vimark/Leadtech-arduino-CSPG/hardware/docs/contact_circuit_protection.pdf

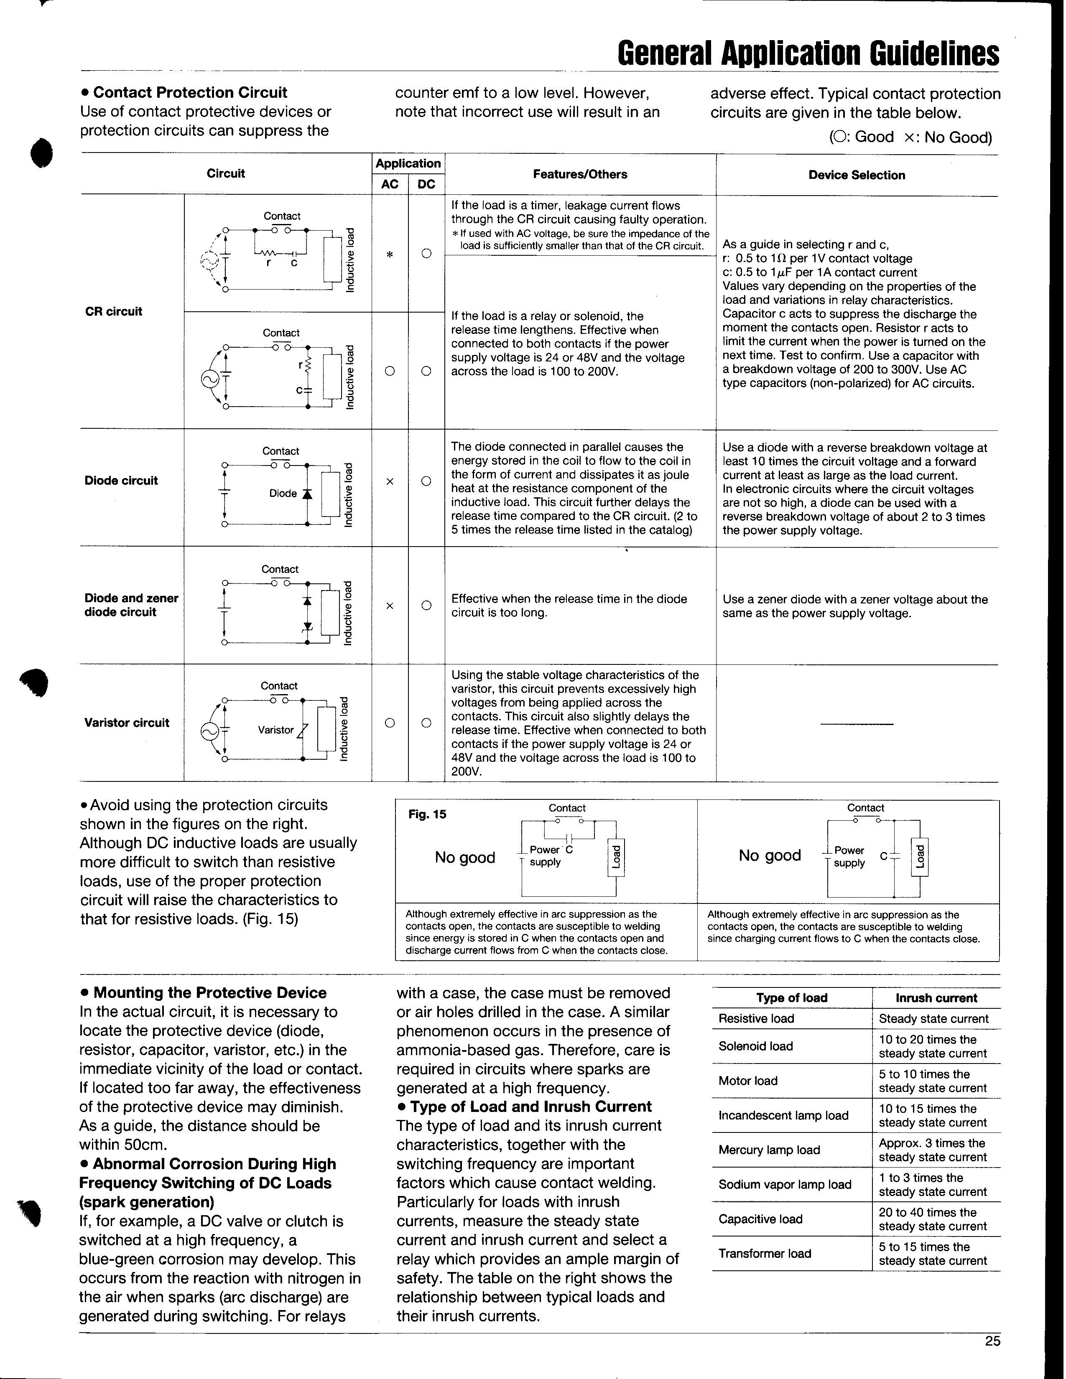
[picture p1: page 1]
