vimark/Leadtech-arduino-CSPG/hardware/docs/Astron RS-35A, RS-35M schematic.pdf

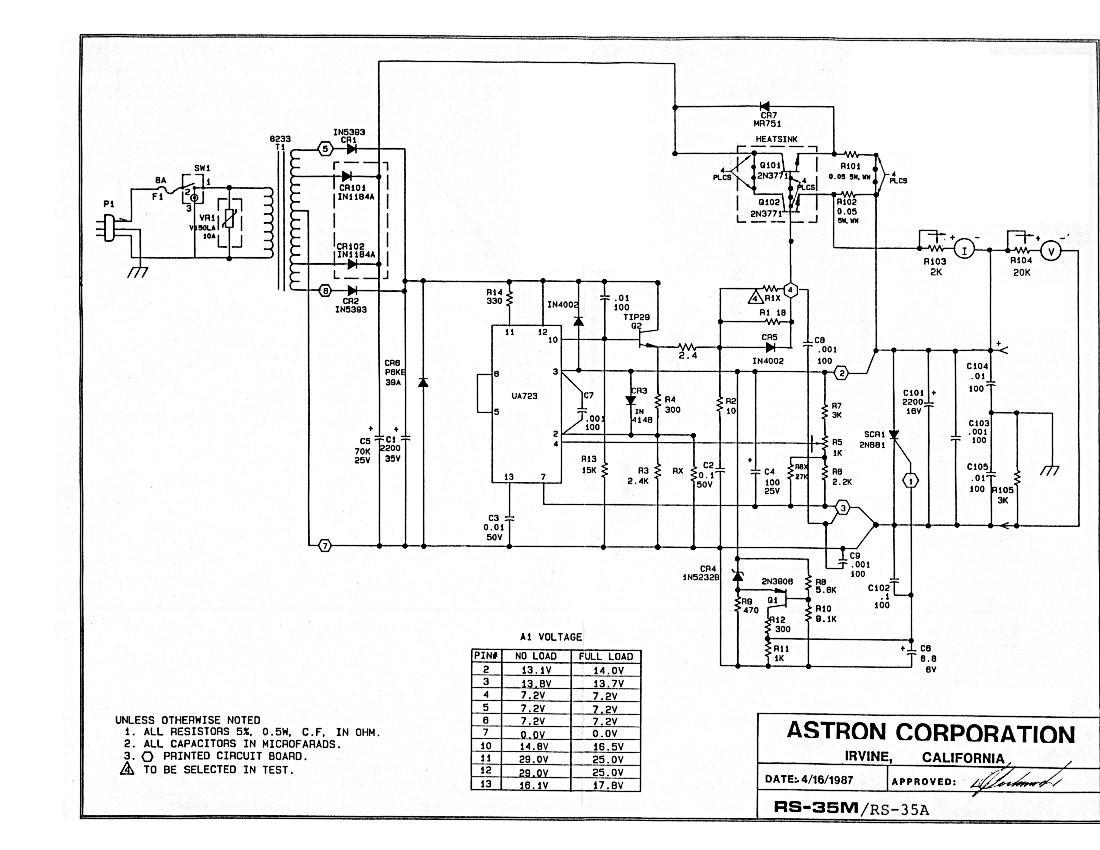
[picture p2: page 1]
