vimark/Leadtech-arduino-CSPG/hardware/docs/1.3 inch oled 128x64 i2c 3-1000x1000.jpg

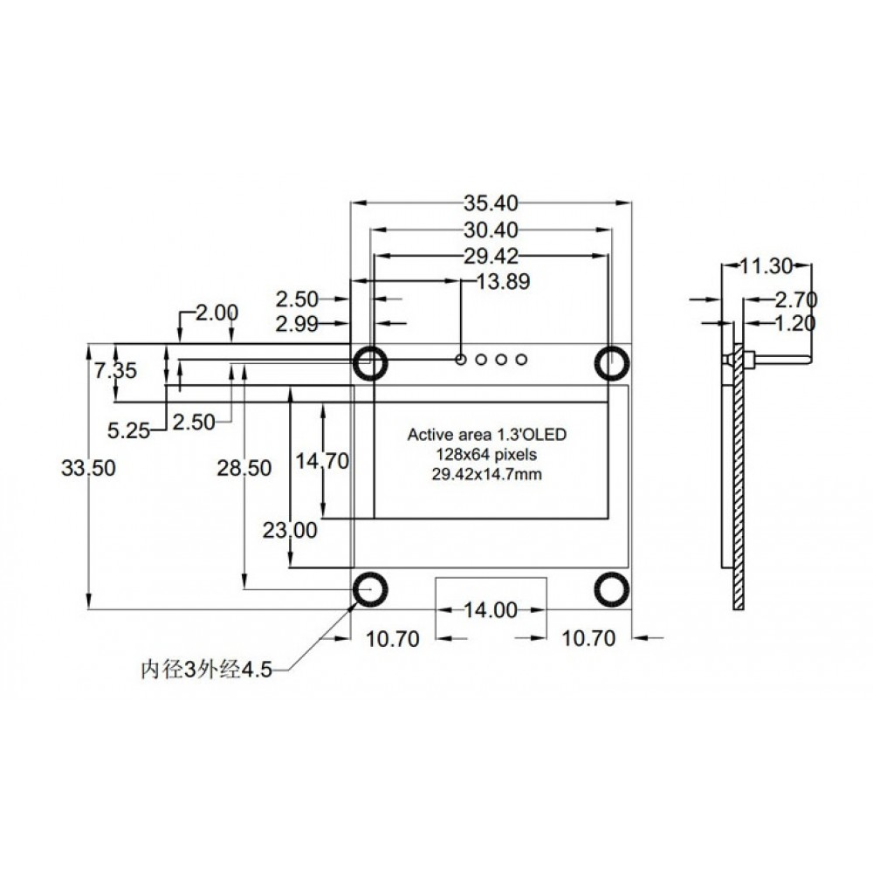
hardware/docs/1.3 inch oled 128x64 i2c 3-1000x1000.jpg
