vimark/Leadtech-arduino-CSPG/hardware/leadtech-arduino-CSPG_concept-bom.xlsx

Qty | Value | Device | Package | Parts | Description | LCSC part no | Mfr no | Brand | Price | Desciption |  | Multiple of 10 | 10
1 |  | LED-0805 | LED-805 | LED1 | Light Emitting Diode | C131244 | 17-21SURC/S530-A2/TR8 | Everlight Elec | $0.014274 |  | $0.01
1 |  | TRANSISTOR_FET_TSM2301CX | SOT-23 | Q1 | 20V P-Channel Enhancement Mode MOSFET | C375701 | GP2301 | GP(GreenPower) | $0.031213 |  | $0.03
10 | 0.1uF | C-EUC0603 | C0603 | C4, C5, C6, C8, C9, C10, C11, C12, C13, C18 | CAPACITOR, European symbol | C490602 | C0603C104J5RAC | KEMET | $0.009275 |  | $0.09
1 | 100R | R-EU_R0603 | R0603 | R16 | RESISTOR, European symbol | C125923 | AC0603FR-07100RL | YAGEO | $0.004202 |  | $0.004202
3 | 100uF 16V |  | CASE_C | C1, C3, C7 | Polarized capacitor in various packages | C336761 | EEEFK1C101SR | PANASONIC | $0.171212 |  | $0.51
13 | 10K | R-EU_R0603 | R0603 | R11, R12, R13, R14, R5, R6, R9, R10, R15, R17, R18, R19, R20 | RESISTOR, European symbol | C191124 | ERJ3EKF1002V | PANASONIC | $0.007858 |  | $0.10
1 | 10uF | C-EUC0805 | C0603 | C2 | CAPACITOR, European symbol | C76614 | C1608X5R1E106MT000E | TDK | $0.057504 |  | $0.06
2 | 10uF | CAPACITOR_POL-CASE_B | CASE_B | C16, C17 | Polarized capacitor in various packages | C178278 | EMZA160ADA100MD61G | NCC(Nippon Chemi-Con) | $0.044415 |  | $0.09
1 | 16Mhz | XTAL/S | QS | X1 | CRYSTAL | C114981 | E49A16E00000KE10CO | Hosonic Elec | $0.111524 |  | $0.11
2 | 1K | RESISTOR-0603 | R603 | R7, R8 |  | C253329 | ESR03EZPJ102 | ROHM Semicon | $0.014148 |  | $0.03
1 | 1N4004 | 1N4004 | DO41-10 | D1 | DIODE | C232435 | 1N4004G | ON Semiconductor | $0.039184 | 400V 1A 1.1V @ 1A Axial Diodes - General Purpose RoHS | $0.04
2 | 22pF | CAPACITOR_NPOL-0805 | C0603 | C14, C15 | Non-Polarized capacitor in various packages | C309441 | AC0603JRNPO9BN220 | YAGEO | $0.016323 |  | $0.03
1 | 2510-4AGW | CON_KF2510-4AGW-2 | KF2510-4AGW-2 | J3 |  | C59729 | 2510-4AGW | BOOMELE(Boom Precision Elec) | $0.018269 | KF2510 Header Male Pin 0.100"(2.54mm) 4 DIP,P=2.54mm Wire To Board / Wire To Wire Connector RoHS | $0.02
1 | 32.768khz | OSC-XTALTC-26 | TC-26 | X2 |  | C255873 | Q11C02RX1001300 | Seiko Epson | $0.114496 | 32.768KHz ±20ppm 6pF 35 KOhm(Max) Radial,2x6mm Radial Cylinder Crystals RoHS | $0.11
1 | 330R | RESISTOR-0603 | R603 | R4 |  | C384242 | WR06X331 JTL | Walsin Tech Corp | $0.001793 |  | $0.001793
1 | 4050D | 4050D | SO16 | U9 | Hex non-inverting BUFFER | C118326 | HEF4050BT,653 | Nexperia | $0.180303 |  | $0.18
2 | 800mA | FERRITE-0805 | FB805 | L1, L2 | Ferrite bead in various packages | C107330 | MMZ2012S800AT | TDK | $0.018687 |  | $0.04
1 | ATMEGA1281 | ATMEGA1281 | TQFP-64 | U6 |  | C39168 | ATMEGA1281-16AU | Microchip Tech | $7.393939 | 8-Bit FLASH AVR 16MHz 2.7V ~ 5.5V TQFP-64_14x14x08P ATMEL & AVR RoHS | $7.39
1 | AZ1117CH2-3.3TRG1 | VREG-RT9163 | SOT-223 | U7 | 500mA Low Dropout Positive Voltage Regulator | C108492 | AZ1117CH2-3.3TRG1 | Diodes Incorporated | $0.116800 | Fixed 15V 3.3V 800mA SOT-223 Linear Voltage Regulators RoHS | $0.12
1 | CON_HEADER_1X02-PTH | CON_HEADER_1X02-PTH | M1X2 | J2 | optional |  |  |  |  |  | $0.00
1 | CON_HEADER_1X08-PTH | CON_HEADER_1X08-PTH | M1X8 | J5 |  | C124416 | C124416 | Ckmtw(Shenzhen Cankemeng) | $0.097435 | Female Header Female Socket 0.100"(2.54mm) 8 1 Through Hole,P=2.54mm Pin Header & Female Header RoHS | $0.10
1 | CON_HX42003_2 | CON_HX42003_2 | HX42003-2WAF | J1 | Similar 5569 series | C185087 | HX42003-2WAF | HX(Zhejiang Yueqing Hongxing Elec) | $0.067440 | 5569 Header Male Pin 0.118"(3.00mm) 2 Through Hole Wire To Board / Wire To Wire Connector RoHS | $0.07
1 | CON_KF2510-2AGW | CON_KF2510-2AGW | KF2510-2AGW | J4 | KF2510 alike | C30436 | C30436 | BOOMELE(Boom Precision Elec) | $0.006429 |  | $0.01
1 | CR2032-BS-6-1 | CR2032 | CR2032-BS-6 | BATT1 |  | C70377 | CR2032-BS-6-1 | Q&J | $0.136384 | SMD Battery Holders, Clips & Contacts RoHS | $0.14
1 | DS1302 | DS1302 | SOIC-8 | U5 | Trickle-charge timekeeping chip | C8959 | DS1302Z+T&R | Maxim Integrated | $0.554545 | Clock/Calendar 31B HH:MM:SS (12/24 hr) YY-MM-DD-dd 3-Wire Serial SOIC-8_150mil Real-time Clocks RoHS | $0.55 | 2
1 | ESP8266-07 | ESP8266-07 | ESP8266-07 | U10 | ESP-07 802.11 b/g/n Wi-Fi Module |  |  |  |  |  | $0.00
1 | F/TMB | F/TMB | F/TMB | SG1 | BUZZER Source: Buerklin | C96093 | TMB12A05 | Jiangsu Huaneng Elec | $0.174480 | Magnetic YES 2300±400Hz 85dB @ 5V, 10cm 5V Φ12mm Through Hole 7.62 Buzzers RoHS | $0.17
1 | MP1584EN_MODULE | MP1584EN_MODULE | MP1584EN_DCDC_MODULE | U1 |  |  |  |  |  |  | $0.00
1 | LM358 | LM358 | SO08 | U8 | Generic op-amp footprint | C383852 | TSV358 | Trusignal Microelec | $0.106343 | SO-8 General Purpose Amplifiers RoHS | $0.11
1 | PL2303TA | PL2303TA | SSOP-28 | U3 | USB to serial bridge controller | C8691 | PL2303TA | Prolific Tech | $1.312121 |  | $1.31
1 | RT9163-3.3V | VREG-RT9163 | SOT-223 | U4 | 500mA Low Dropout Positive Voltage Regulator | C150719 | AP7361-33E-13 | Diodes Incorporated | $0.126697 | Fixed 6V 3.3V 1A SOT-223 Low Dropout Regulators(LDO) RoHS | $0.13
1 | USB micro |  |  | USB1 | USB Female connector | C114094 | 47589-0001 | MOLEX | $0.360606 |  | $0.36
1 | VREG-78M05 | VREG-78M05 | DPAK-3 | U2 | 78M05 | C310413 | L7805CDT-TR | STMicroelectronics | $0.213636 | Fixed 35V 5V 1.5A TO-252-3 Linear Voltage Regulators RoH | $0.21
1 |  |  |  | J6 |  | C29275 | C29275 | BOOMELE(Boom Precision Elec) | $0.008877 | KF2510 Header Male Pin 0.100"(2.54mm) 3 3P Wire To Board / Wire To Wire Connector RoHS | $0.01 | not added to cart
1 | F1206 |  |  | F1 |  | C183290 | SCF075-1206R | SOCAY | $0.054459 | 8V 1.5A SMD1206 PTC Resettable Fuses RoHS | $0.05
 |  |  |  |  |  |  |  |  |  | Total | $12.20
