vimark/Leadtech-arduino-CSPG/hardware/LM723 voltage regulator-bom.xlsx

Qty | Value | Device | Package | Parts | Description | LCSC
2 | 0.1uF | C-EU075-042X103 | C075-042X103 | C2, C4 | CAPACITOR, European symbol | C490602
1 | 0.47uF | C-EU075-042X103 | C075-042X103 | C1 | CAPACITOR, European symbol
1 | 0R | RESISTOR-V | R_5V_EXPAD | R25
4 | 100K | RESISTOR-V | R_5V_EXPAD | R7, R12, R14, R15 |  | C120103 | CF1/4W-100KΩ±5% T52 | CCO(Chian Chia Elec) | $0.004875
1 | 100uF 35V | CPOL-EUE2.5-7 | E2,5-7 | C3 | POLARIZED CAPACITOR, European symbol
1 | 10K | R-EU_0207/12 | 0207/12 | R10 | RESISTOR, European symbol | C433778 | RD 1/4W 10K J T/B A1 | TyoHM | $0.006004
8 | 10K | RESISTOR-V | R_5V_EXPAD | R6, R17, R19, R20, R22, R23, R26, R27 |  | C433778 | RD 1/4W 10K J T/B A1 | TyoHM | $0.006004
2 | 10R | RESISTOR-V | R_5V_EXPAD | R1, R2 |  | C433800 | RD 1/2WS 10R J T/B A1 | TyoHM RD | $0.006004
1 | 1K | RESISTOR | R-5_EXPAD | R16
1 | 1R 5W | RESISTOR-5W | RESISTOR_5W | R3 | 22 x 9.5 mm cement resistor
1 | 2.2K | RESISTOR-V | R_5V_EXPAD | R11
1 | 2N3055 | 2N3055 | TO3 | Q3 | NPN Transistor
1 | 2N3904 | TRANSISTOR_BJT_NPN-TO-92-EBC | TO-92 | Q2 | Most commonly used is SOT23-BEC
2 | 2SA1015 | TRANSISTOR_BJT_PNP-TO-92-ECB | TO-92 | Q1, Q4 | Most commonly used is SOT23-BEC
1 | 3.3K | RESISTOR-V | R_5V_EXPAD | R9
1 | 30K | RESISTOR-V | R_5V_EXPAD | R18
1 | 470R | RESISTOR-V | R_5V_EXPAD | R5 |  | C384220 | WR06X471 JTL | Walsin Tech Corp | $0.002101
1 | 47R | RESISTOR-V | R_5V_EXPAD | R13
1 | 50R | TRIMMER-3362P_EXPAD | TRIMMER_3362P_EXPAD | R24 | Trimmer resistor | C124583 | 3362P-1-500LF | BOURNS | $0.204545
1 | 5K | TRIMMER-3362P_EXPAD | TRIMMER_3362P_EXPAD | R21 | Trimmer resistor | C81260 | 3362P-1-502LF | BOURNS | $0.210606
1 | 10K | TRIMMER-3362P_EXPAD | TRIMMER_3362P_EXPAD | R8 | Trimmer resistor | C118956 | 3362P-1-103 | BOCHEN(Chengdu Guosheng Tech) | $0.131208
1 | 6.3V | 1N4728 | DO41Z10 | D1 | Z DIODE
1 | CON_HEADER_1X03-PTH | CON_HEADER_1X03-PTH | M1X3 | J3
2 | CON_TERMINAL_BLOCK_02-5MM | CON_TERMINAL_BLOCK_02-5MM | TERMINAL_BLOCK_2P_5 | J1, J2 | 2 poles wire to board terminal block
1 | FRAME_DINA4_L | FRAME_DINA4_L | DP_LOGO | PAGE1 | A4 DP frame
1 | LM358 | IC_OP-AMP_LM358-EXPAD | DIP8-EXPAD | IC1 | Dual op-amp | C383852 | TSV358 | Trusignal Microelec | $0.106343 | SO-8 General Purpose Amplifiers RoHS
1 | LM723-EXPAD | LM723-EXPAD | DIP14-EXPAD | U1 | LM723 Voltage Regulator
2 | MOUNT-PAD-ROUND3.2 | MOUNT-PAD-ROUND3.2 | 3,2-PAD | H1, H2 | MOUNTING PAD, round
