vimark/Leadtech-arduino-CSPG/hardware/docs/Purchase List - prepaid metering.xlsx

Sheet: Prepaid Solar Metering
Prepaid Solar Metering Kit (Solar Home Kit)
Qty | Particulars | Price | Amount
1 | Gizduino X | 796 | 796
1 | RTC DS1302 breakout | 50 | 50
1 | MP1584EN 3A DC-DC buck | 100 | 100
1 | Buzzer | 10 | 10
1 | 1.3" I2C OLED | 449.75 | 449.75
1 | RC522 RF ID Reader Module | 198.25 | 198.25
1 | 300 x 250 x 150 Metal Box Enclosure | 2000 | 2000
1 | Acrylic Laser cutting cost | 500 | 500
1 | 1/8 12x12 clear acrylic | 110 | 110
1 | 1/8 12x12 black acrylic | 120 | 120
1 | Faceplate Sticker | 10 | 10
1 | Lead Acid battery | 1150 | 1150
2 | Battery lugs | 5 | 10
1 | Fuse Holder | 39 | 39
5 | Hook up wires | 15 | 75
1 | M3 Bolt and nuts | 100 | 100
11 | 1/4W Resistors | 0.3 | 3.3
1 | 5W Resistors | 5 | 5
1 | Capacitor 100uF/35V | 3 | 3
2 | Capacitor ceramic | 1 | 2
2 | Transistor 2SA1015 | 5 | 10
1 | Transistor 2N3055 | 65 | 65
1 | Transistor 2N3904 | 10 | 10
1 | IC LM723 | 25 | 25
1 | 4x6 PCB | 55 | 55
4 | Crown Plug | 10 | 40
1 | Push Button Switch | 18 | 18
1 | Trimmer | 5 | 5
1 | Charge controller | 850 | 850
 | Total |  | 6809.3
1 | Programming labor | 2000 | 2000
1 | Enclosure labor | 500 | 500
 | Total |  | 2500
 | Grand Total |  | 9309.3

Sheet: Prepaid Metering
Prepaid Metering Kit (CSPG connected)
partial 10/22/2019
Qty | Particulars | Price | Amount
25 | NEMA 5X8 Metal Box Enclosure | 380 | 9500
25 | IC LM723 | 25 | 625
25 | 14-pin IC socket | 8 | 200
50 | Transistor 2SA1015 | 5 | 250
25 | Transistor 2N3904 | 10 | 250
25 | Transistor 2N3055 | 65 | 1625
25 | Capacitor 100uF/35V | 3 | 75
25 | 1Ohm 5W Resistors | 5 | 125
25 | Push Button Switch | 18 | 450
25 | 24V to 12V DC-DC converter | 680 | 17000
50 | 5K Trimmer | 5 | 250
25 | 5Ohms Trimmer | 5 | 125
50 | 0.047uF 50V Capacitor ceramic | 1 | 50
25 | 0.1uF 50V Capacitor ceramic | 1 | 25
25 | 10 Ohm 1/4W Resistors | 0.3 | 7.5
75 | 100K 1/4W Resistors | 0.3 | 22.5
50 | 3.3K 1/4W Resistors | 0.3 | 15
25 | 5K 1W Resistors | 1 | 25
25 | 2.2K 1/4W Resistors | 0.3 | 7.5
25 | 470 Ohm 1/4W Resistors | 0.3 | 7.5
50 | 10K 1/4W Resistors | 0.3 | 15
25 | 47 Ohm 1/4W Resistors | 0.3 | 7.5
2 | 12x12 Presensitize PCB | 500 | 1000
 | Total |  | 31657.5 | budget given to ariel on 10-22-2019 (a total of 35000)
1 | Acrylic Laser cutting cost | 500 | 500
1 | 1/8 12x12 clear acrylic | 110 | 110
1 | 1/8 12x12 black acrylic | 120 | 120
1 | Faceplace sticker | 10 | 10
1 | Fuse Holder | 39 | 39
5 | Hook up wires | 15 | 75
1 | M3 Bolt and nuts | 100 | 100
1 | 4x6 PCB | 55 | 55
4 | Crown Plug | 10 | 40
1 | Trimmer | 5 | 5
1 | Terminal screw Block | 50 | 50
 | Total |  | 64419
1 | Programming labor | 2000 | 2000
1 | Enclosure labor | 500 | 500
 | Total |  | 2500
 | Grand Total |  | 66919

Sheet: Prepaid Loader
Prepaid Loader (Vendor)
Qty | Particulars | Price | Amount
1 | Gizduino X | 796 | 796
1 | RTC DS1302 breakout | 50 | 50
1 | MP1584EN 3A DC-DC buck | 100 | 100
1 | Buzzer | 10 | 10
1 | 1.3" I2C OLED | 449.75 | 449.75
1 | RC522 RF ID Reader Module | 198.25 | 198.25
1 | Mini thermal printer | 1700 | 1700
1 | Acrylic Laser cutting cost | 500 | 500
1 | 1/8 10x10 clear acrylic | 75 | 75
1 | 4.5mm 17x17 black acrylic | 394 | 394
1 | Faceplate sticker | 10 | 10
1 | Fuse Holder | 39 | 39
5 | Hook up wires | 15 | 75
1 | M3 Bolt and nuts | 100 | 100
1 | 4x6 PCB | 55 | 55
1 | Crown Plug | 10 | 10
1 | Push Button Switch | 18 | 18
1 | 12V power adaptor | 300 | 300
1 | Self adhesive 20mm footing | 60 | 60
1 | Super Glue | 89 | 89
1 | 57mm x 30m thermal paper | 35 | 35
 | Total |  | 5064
1 | Programming labor | 2000 | 2000
1 | Enclosure labor | 500 | 500
 | Total |  | 2500
 | Grand Total |  | 7564
