vimark/Leadtech-arduino-CSPG/(list of files, cad)

Other CAD files:
hardware/dwg/vendor_box.dwg
hardware/under-pcb-kicad/under_pcb_placement.FCStd
hardware/dwg/box_plate.dwg
hardware/dwg/connections.dwg
hardware/dwg/box-20190914_032513_692832.dxf
