vimark/Leadtech-arduino-CSPG/hardware/Test result.xlsx

Sheet: Sheet1
LM723 Voltage Regulator CSPG Module
 | I (A) | V (v)
Initial | 0.056 | 12.11
 | 0.100 | 12.11
 | 0.200 | 12.11
 | 0.300 | 12.10
 | 0.400 | 12.10
 | 0.500 | 12.10
 | 0.600 | 12.10
 | 0.700 | 12.10
 | 0.800 | 12.10
 | 0.900 | 12.10
 | 1.000 | 12.10
 | 1.100 | 12.09
 | 1.200 | 12.09
 | 1.300 | 12.09
 | 1.400 | 12.09

Sheet: TL494 Test points
Description
1. Remove first the chopper mosfet
OV test - remove 15V zener diode cathode, place potentiometer pin 1 to gnd, pin 2 to 15V zener cathode and pin 3 to +VIN, power on and slowly turn up the potentiometer till the relay shuts down. Trip voltage should be >18V
 |  |  | No mosfet |  |  |  | With mosfet
 | V-Batt | OV test | +13V rail test | +22 rail test | +5Vref test | Oscillator | +13V rail test | +22 rail test | Vout @ 150mA | Vout @ 1.5A | Pulsing/Unregulated below
B9 | 49.33V | 18.2V | 6.9V | 21.8V | 5.03V | 103Khz | 13.45V | 22.11V | 14.06V | 14.02V | 150mA
B10 | 49.66V | 18.65V | 6.9V | 21.62V | 5.036V | 105.8Khz | 13.43V | 21.72V | 14.02V | 14.01V | 300mA+
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
