vimark/Leadtech-arduino-CSPG/hardware/leadtech-arduino-base-design.pdf

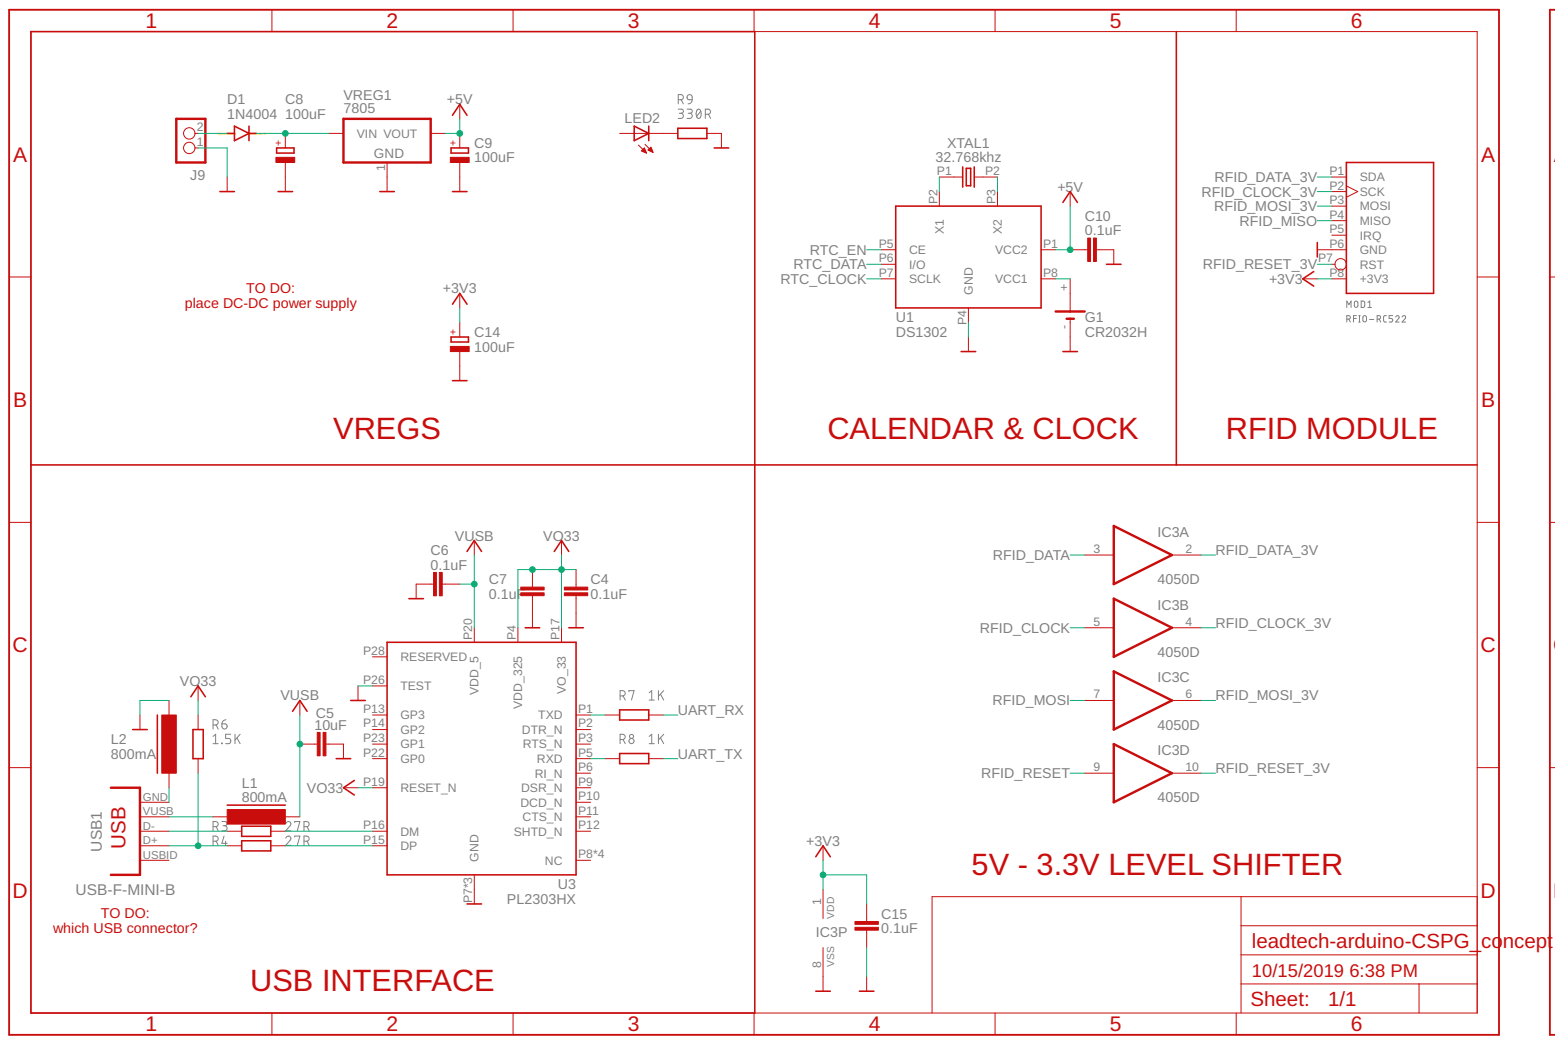
[picture p4: page 1]

TO DO: place DC-DC power supply

TO DO: which USB connector?

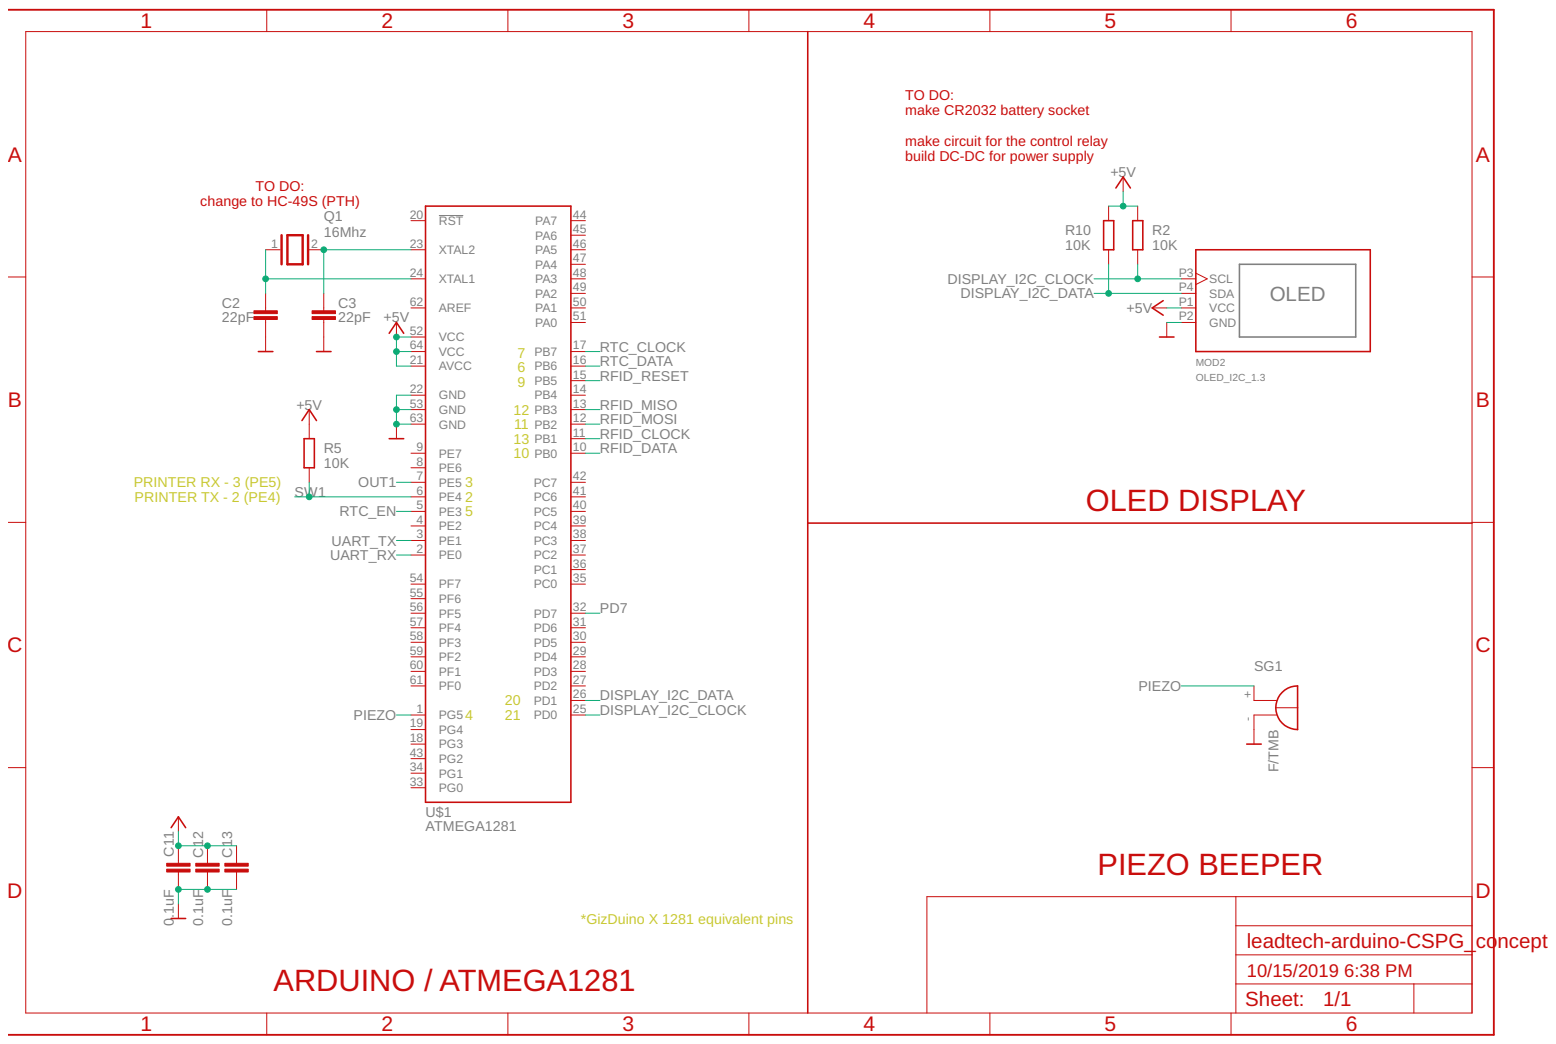
[picture p5: page 2]

TO DO: make CR2032 battery socket make circuit for the control relay build DC-DC for power supply

TO DO: change to HC-49S (PTH) | +5V

3 PRINTER TX - 2 (PE4) PRINTER RX - 3 (PE5)
