vimark/Leadtech-arduino-CSPG/hardware/LM723 voltage regulator.pdf

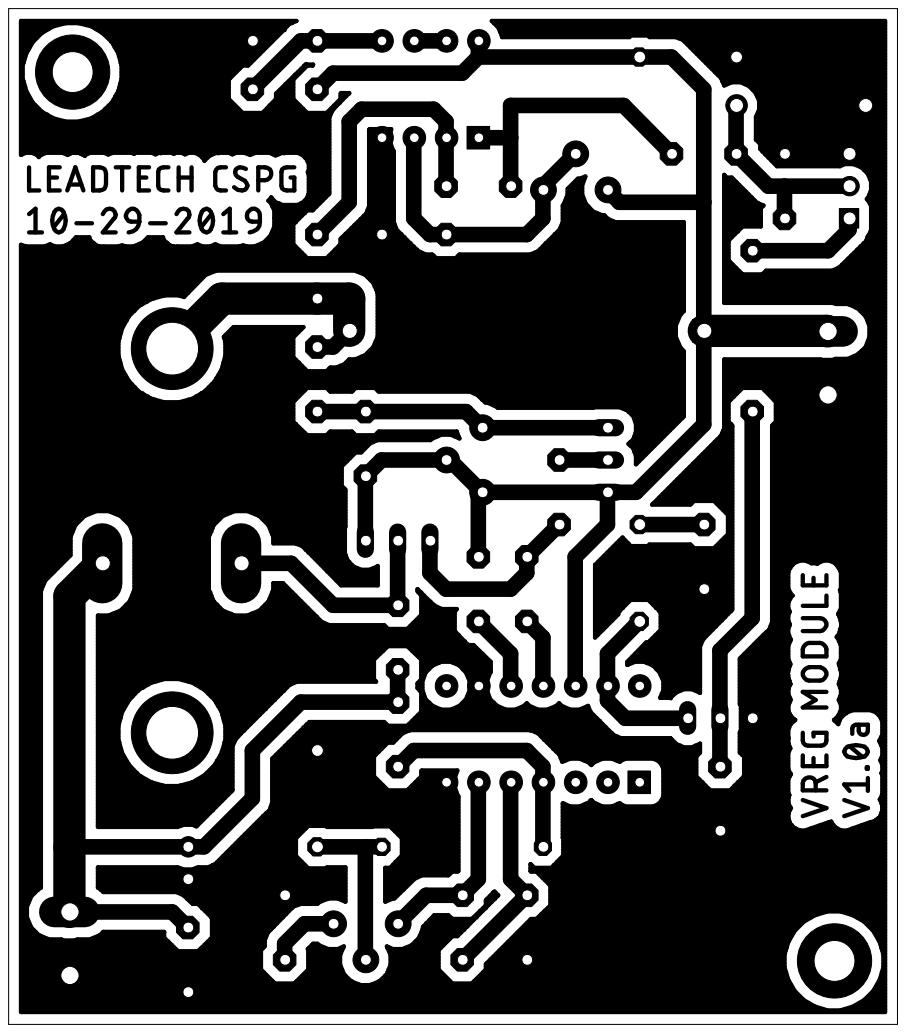
[picture p6: page 1]
