vimark/Leadtech-arduino-CSPG/hardware/LM723 voltage regulator v1a_ x2.pdf

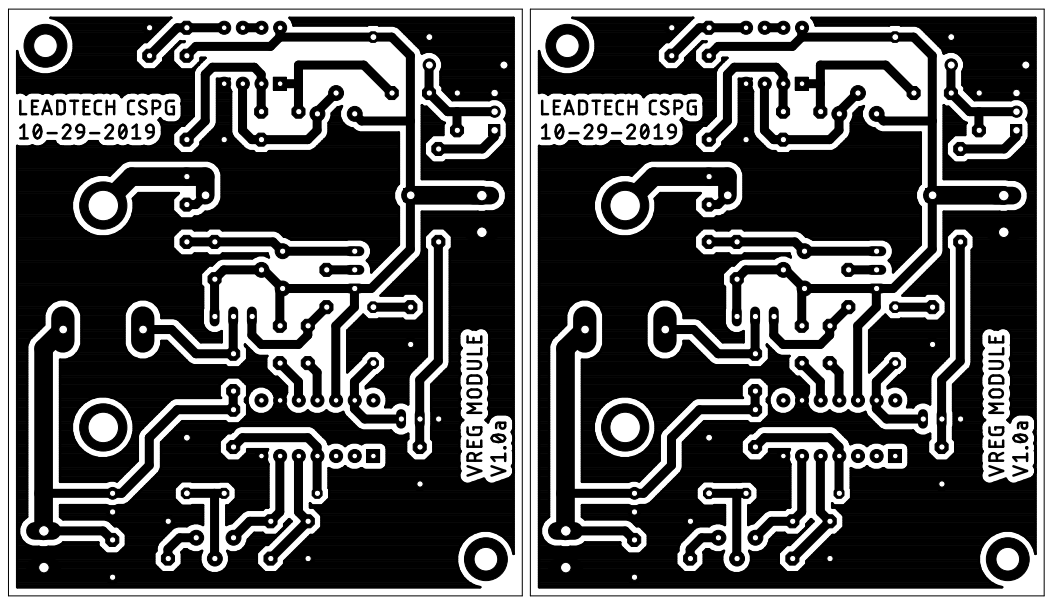
[picture p7: page 1]
