vimark/Leadtech-arduino-CSPG/hardware/leadtech-arduino-CSPG_concept.pdf

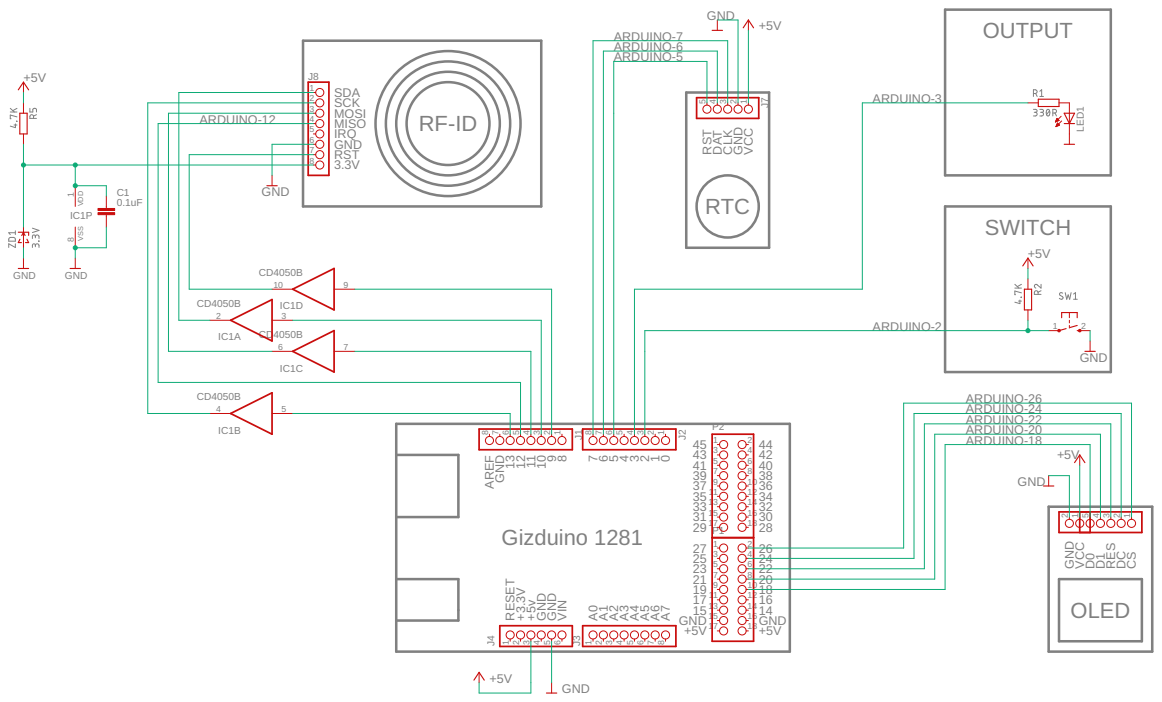
[picture p8: page 1]
