vimark/Leadtech-arduino-CSPG/hardware/docs/gizduino_x_1281.pdf

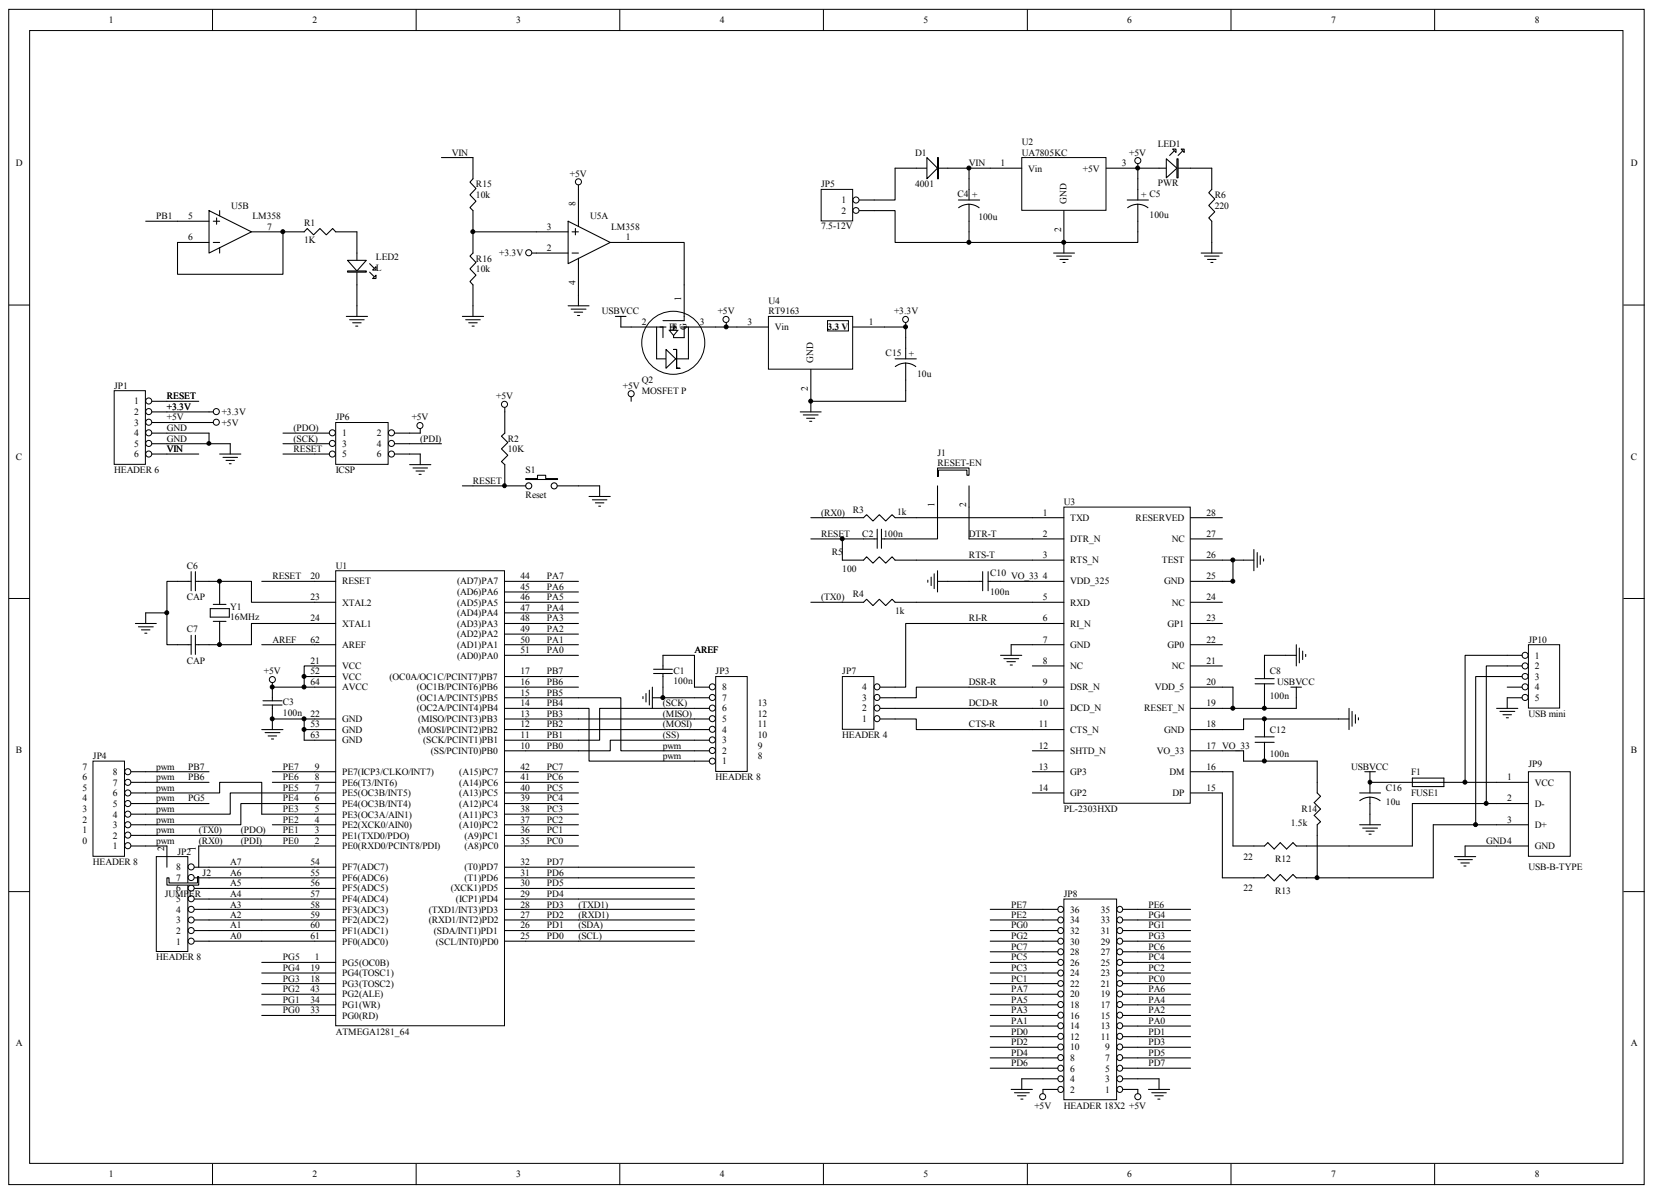
[picture p9: page 1]
