vimark/Leadtech-arduino-CSPG/spice/cspg_dc_voltage_sense_amp.asc

D1: zener; BZX84B12VL
D2: diode
R1: res; 100K
R2: res; 10K
R3: res; 10K
R6: res; 10K
R7: res; 50K
R8: res; 10K
U1: LT1413
V1: voltage; 24
V2: voltage; SINE(0 18 60); AC 18
Named nets: 0, Vinv, Vout-opamp, vout
.tran 100m
