vimark/Leadtech-arduino-CSPG/spice/current_sense_amp.asc

D1: zener; BZX84B12VL
I1: current; SINE(0 0.05 60); AC 0.05
R3: res; 10K
R4: res; 10K
R5: res; 10K
R6: res; 10K
R7: res; 50K
R8: res; 10K
R10: res; 33
U1: LT1413
V1: voltage; 24
Named nets: 0, Vinv, Vout-opamp, Vadc, vout
.tran 100ms
