vimark/Leadtech-arduino-CSPG/spice/current_sense_arduino.asc

I1: current; 1
R1: res; 1; pwr=5W
R2: res; 10K
R3: res; 2.7K
R4: res; 10K
R5: res; 10K
R6: res; 10K
R7: res; 30K
U1: LT1413
V1: voltage; 14
Named nets: 0, Vnon-inv, Vinv, Vin, Vload, Vout-opamp, Vadc
.tran 1
