vimark/Leadtech-arduino-CSPG/spice/lm723_voltage_regulator.asc

C1: cap; 100n
C2: cap; 100n
C3: cap; 100µ
C4: cap; 100n
C5: cap; 1µ
D1: zener; BZX84B9V1L
Q1: pnp
Q2: pnp
Q3: npn
Q4: npn
Q5: npn
R1: res; 1
R2: res; 10
R3: res; 10K
R4: res; 1K
R5: res; 47
R6: res; 100K
R7: res; 10K
R8: res; 3.3K
R9: res; 4k
R10: res; 1k
R11: res; 10K
R12: res; 100K
R13: res; 4.7K
R14: res; 17.412K
R15: res; 10K
R16: res; 3.3K
R17: res; 10K
R18: res; 30K
R19: res; 1K
R20: res; 50
U1: LT1413
U2: LT1413
U3: LT1413
V1: voltage; 14
Named nets: 0, Vin, Vload, Vnon-inv, Vinv
.tran 10ms startup
