vimark/Leadtech-arduino-CSPG/hardware/under-pcb-kicad/under_pcb/under_pcb.kicad_pcb

## KiCad design hardware/under-pcb-kicad/under_pcb/under_pcb.kicad_pcb (2020-03-01)

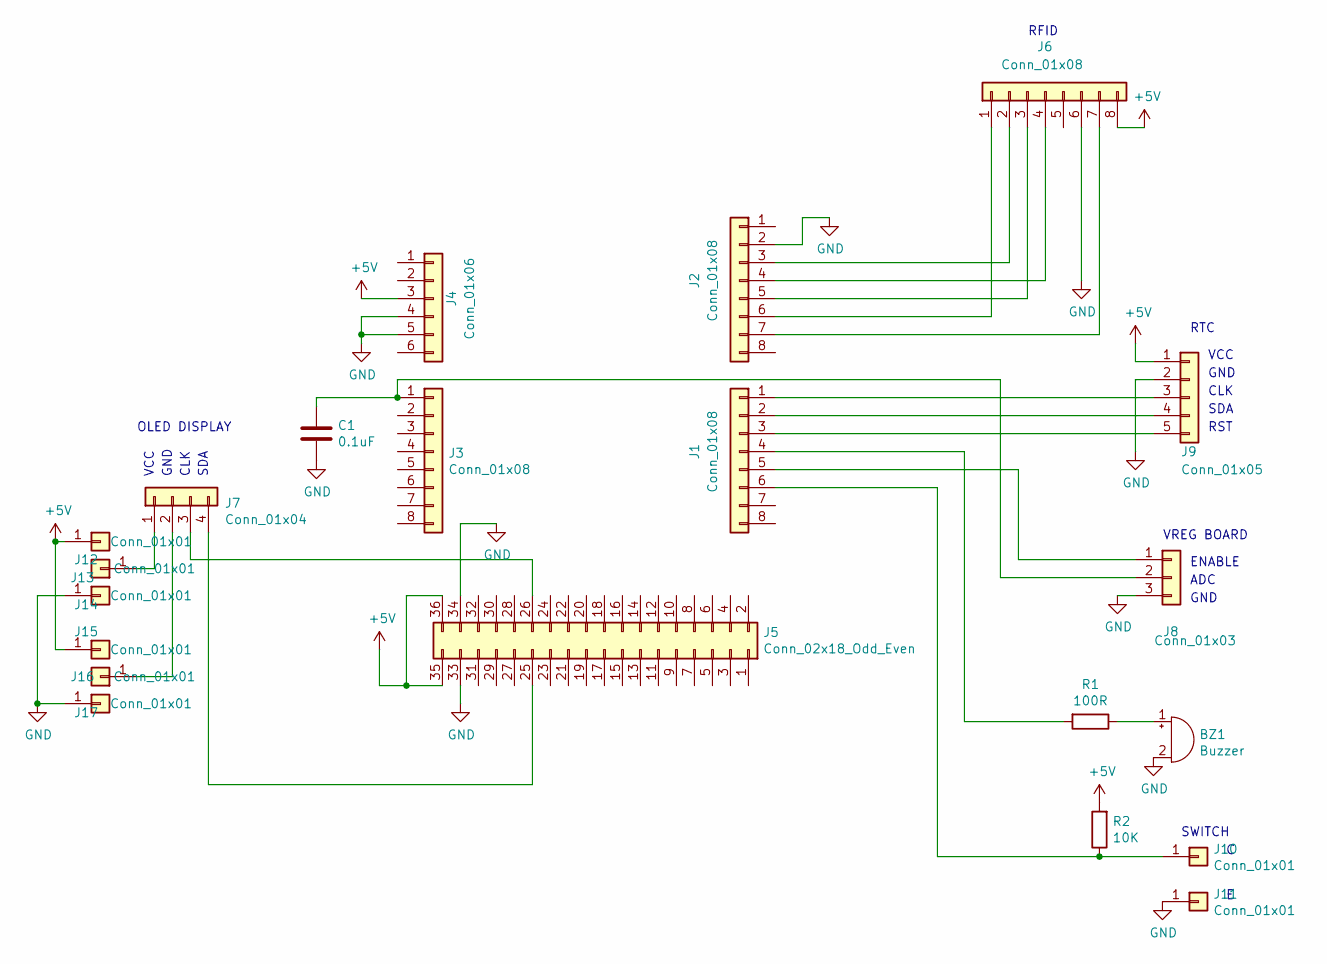
[picture p10: schematic under_pcb.sch]

Parts:
BZ1: Buzzer; Buzzer_12x9.5RM7.6
C1: 0.1uF; C_Disc_D5.0mm_W2.5mm_P2.50mm
J1, J2, J3, J6: Conn_01x08; PinSocket_1x08_P2.54mm_Vertical
J4: Conn_01x06; PinSocket_1x06_P2.54mm_Vertical
J5: Conn_02x18_Odd_Even; PinSocket_2x18_P2.54mm_Vertical
J7: Conn_01x04; PinSocket_1x04_P2.54mm_Vertical
J8: Conn_01x03; PinSocket_1x03_P2.54mm_Vertical
J9: Conn_01x05; PinSocket_1x05_P2.54mm_Vertical
J10, J11, J12, J13, J14, J15, J16, J17: Conn_01x01; PinSocket_1x01_P2.54mm_Vertical
R1: 100R; R_Axial_DIN0207_L6.3mm_D2.5mm_P10.16mm_Horizontal
R2: 10K; R_Axial_DIN0207_L6.3mm_D2.5mm_P10.16mm_Horizontal

Connections:
+5V: J4.3, J5.35, J5.36, J6.8, J9.1, J12.1, J15.1, R2.2
GND: BZ1.2 (+), C1.2, J2.2, J4.4, J4.5, J5.33, J5.34, J6.6, J8.3, J9.2, J11.1, J14.1, J17.1
unnamed: BZ1.1 (-), R1.1
unnamed: C1.1, J3.1, J8.2
unnamed: J1.1, J9.3
unnamed: J1.2, J9.4
unnamed: J1.3, J9.5
unnamed: J1.4, R1.2
unnamed: J1.5, J8.1
unnamed: J1.6, J10.1, R2.1
unnamed: J2.3, J6.2
unnamed: J2.4, J6.4
unnamed: J2.5, J6.3
unnamed: J2.6, J6.1
unnamed: J2.7, J6.7
unnamed: J5.25, J7.4
unnamed: J5.26, J7.3
unnamed: J7.1, J13.1
unnamed: J7.2, J16.1

Notes on the sheet:
ENABLE
ADC
GND
VREG BOARD
RFID
RTC
VCC
CLK
SDA
RST
OLED DISPLAY
SWITCH

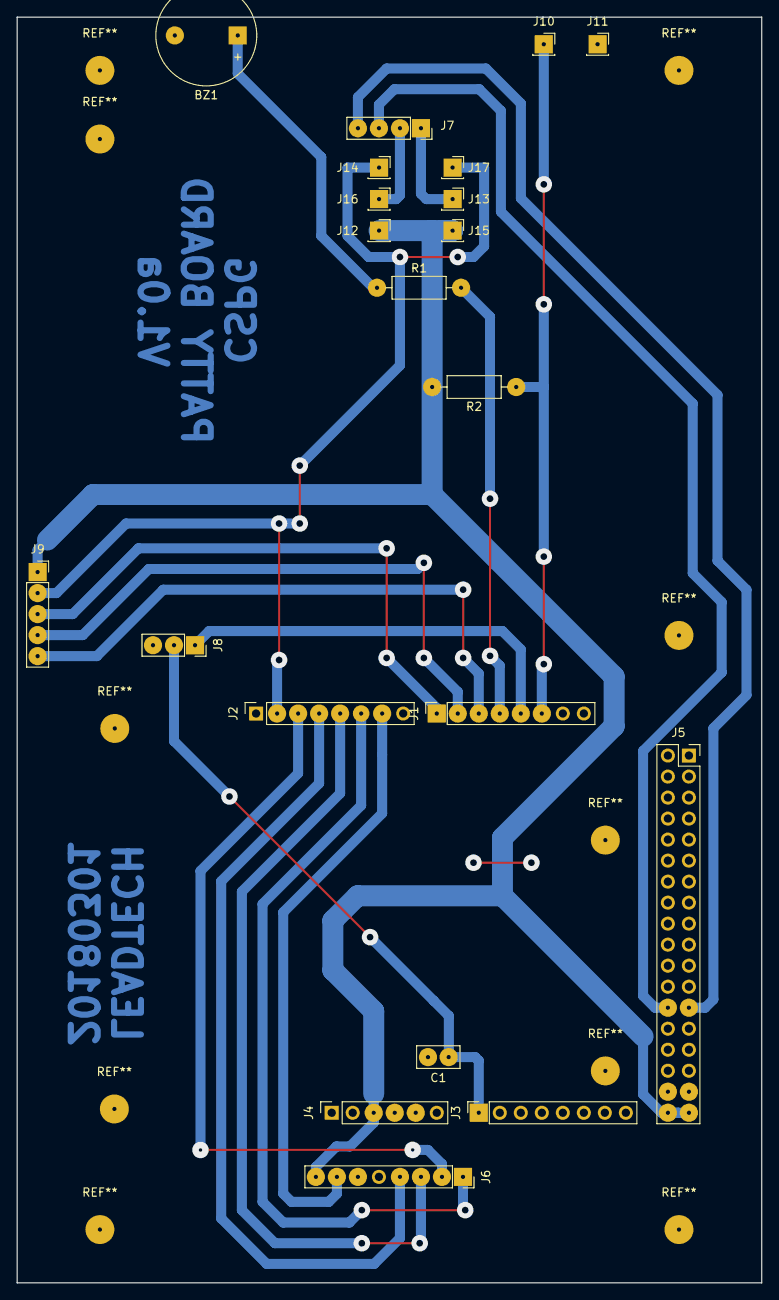
[picture p11: board under_pcb.kicad_pcb from above]

Board: 2 copper layers, 90.0 x 153.0 mm, 21 parts (0 on the bottom side), 19 nets.
