vimark/Leadtech-arduino-CSPG/hardware/LM723 voltage regulator.v1.0a.brd

## EAGLE design hardware/LM723 voltage regulator.v1.0a.brd (2020-03-18)

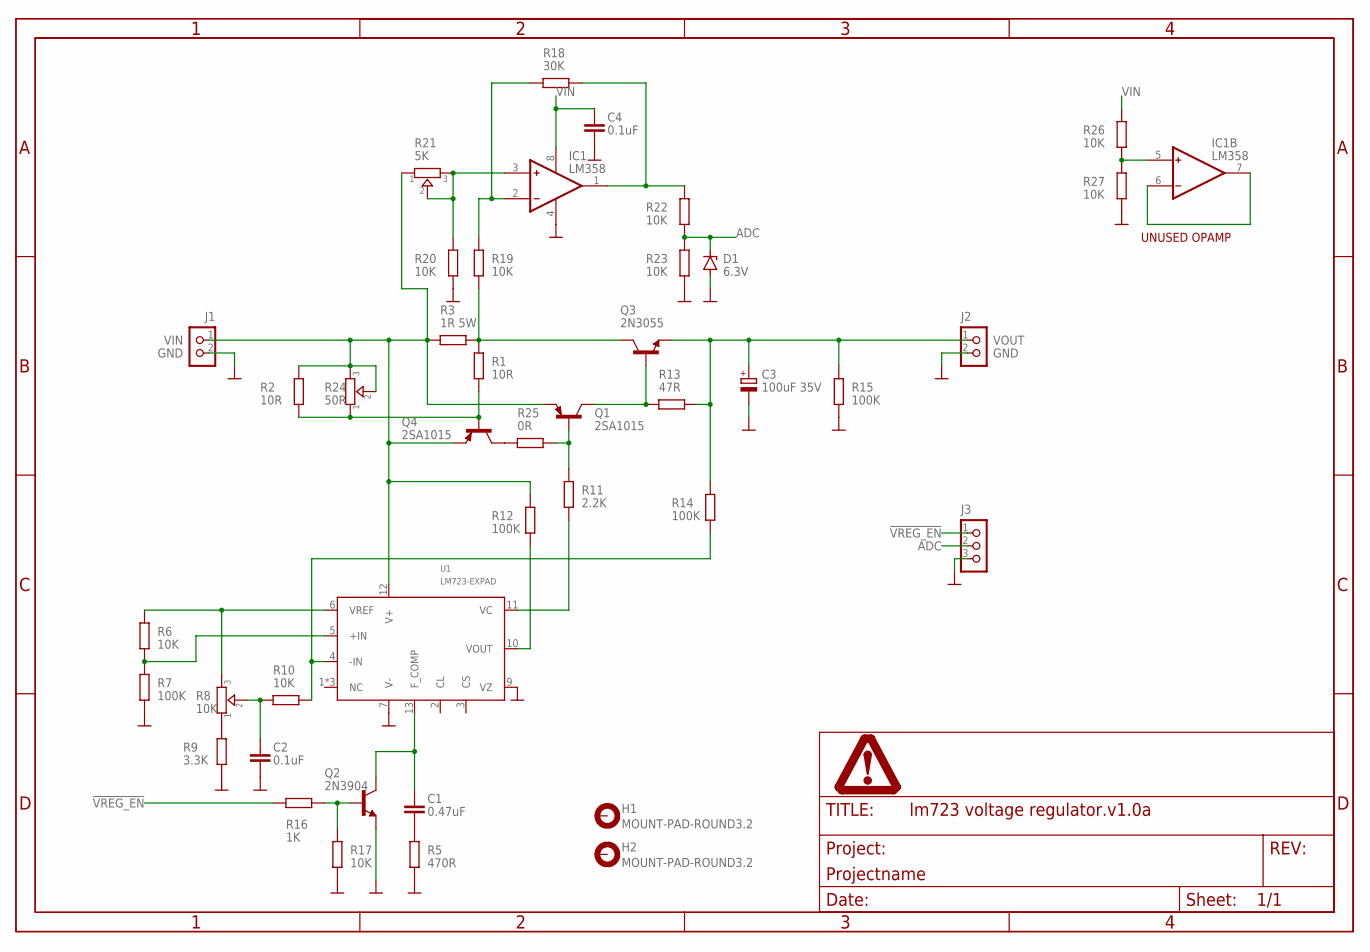
[picture p12: schematic LM723 voltage regulator.v1.0a.sch]

Parts:
C1: 0.47uF; C075-042X103
C2, C4: 0.1uF; C075-042X103
C3: 100uF 35V; E2,5-7
D1: 6.3V; DO41Z10
H1, H2: MOUNT-PAD-ROUND3.2; 3,2-PAD
IC1: LM358; DIP8-EXPAD
J1, J2: CON_TERMINAL_BLOCK_02-5MM; TERMINAL_BLOCK_2P_5
J3: CON_HEADER_1X03-PTH; M1X3
PAGE1: FRAME_DINA4_L; DP_LOGO
Q1, Q4: 2SA1015; TO-92
Q2: 2N3904; TO-92
Q3: 2N3055; TO3
R1, R2: 10R; R_5V_EXPAD
R3: 1R 5W; RESISTOR_5W
R5: 470R; R_5V_EXPAD
R6, R17, R19, R20, R22, R23, R26, R27: 10K; R_5V_EXPAD
R7, R12, R14, R15: 100K; R_5V_EXPAD
R8: 10K; TRIMMER_3362P_EXPAD
R9: 3.3K; R_5V_EXPAD
R10: 10K; 0207/12
R11: 2.2K; R_5V_EXPAD
R13: 47R; R_5V_EXPAD
R16: 1K; R-5_EXPAD
R18: 30K; R_5V_EXPAD
R21: 5K; TRIMMER_3362P_EXPAD
R24: 50R; TRIMMER_3362P_EXPAD
R25: 0R; R_5V_EXPAD
U1: LM723-EXPAD; DIP14-EXPAD

Connections:
!VREG_EN: J3.1, R16.1
ADC: D1.C, J3.2, R22.2, R23.1
GND: C2.2, C3.-, C4.2, D1.A, IC1.4 (V-), J1.2, J2.2, J3.3, Q2.1 (E), R5.1, R7.1, R9.1, R15.1, R17.1, R20.2, R23.2, R27.2, U1.7 (V-), U1.9 (VZ)
unnamed: Q3.C, Q3.C/ (C), R1.2, R3.2, R19.2
unnamed: Q4.3 (B), R1.1, R2.1, R24.1
unnamed: Q1.2 (C), Q3.B, R13.1
unnamed: IC1.2 (-), R18.1, R19.1
unnamed: C1.2, R5.2
unnamed: C1.1, Q2.3 (C), U1.13 (F_COMP)
unnamed: R6.1, R7.2, U1.5 (+IN)
unnamed: R6.2, R8.3, U1.6 (VREF)
unnamed: R8.1, R9.2
unnamed: C2.1, R8.2, R10.1
unnamed: R10.2, R14.2, U1.4 (-IN)
unnamed: Q1.3 (B), R11.2, R25.1
unnamed: R11.1, U1.11 (VC)
unnamed: R12.2, U1.10 (VOUT)
unnamed: IC1.3 (+), R20.1, R21.2, R21.3
unnamed: Q2.2 (B), R16.2, R17.2
unnamed: IC1.1 (OUT), R18.2, R22.1
unnamed: Q4.2 (C), R25.2
unnamed: IC1.6 (-), IC1.7 (OUT)
unnamed: IC1.5 (+), R26.2, R27.1
VIN: C4.1, IC1.8 (V+), J1.1, Q1.1 (E), Q4.1 (E), R2.2, R3.1, R12.1, R21.1, R24.2, R24.3, R26.1, U1.12 (V+)
VOUT: C3.+, J2.1, Q3.E, R13.2, R14.1, R15.2

Notes on the sheet:
UNUSED OPAMP

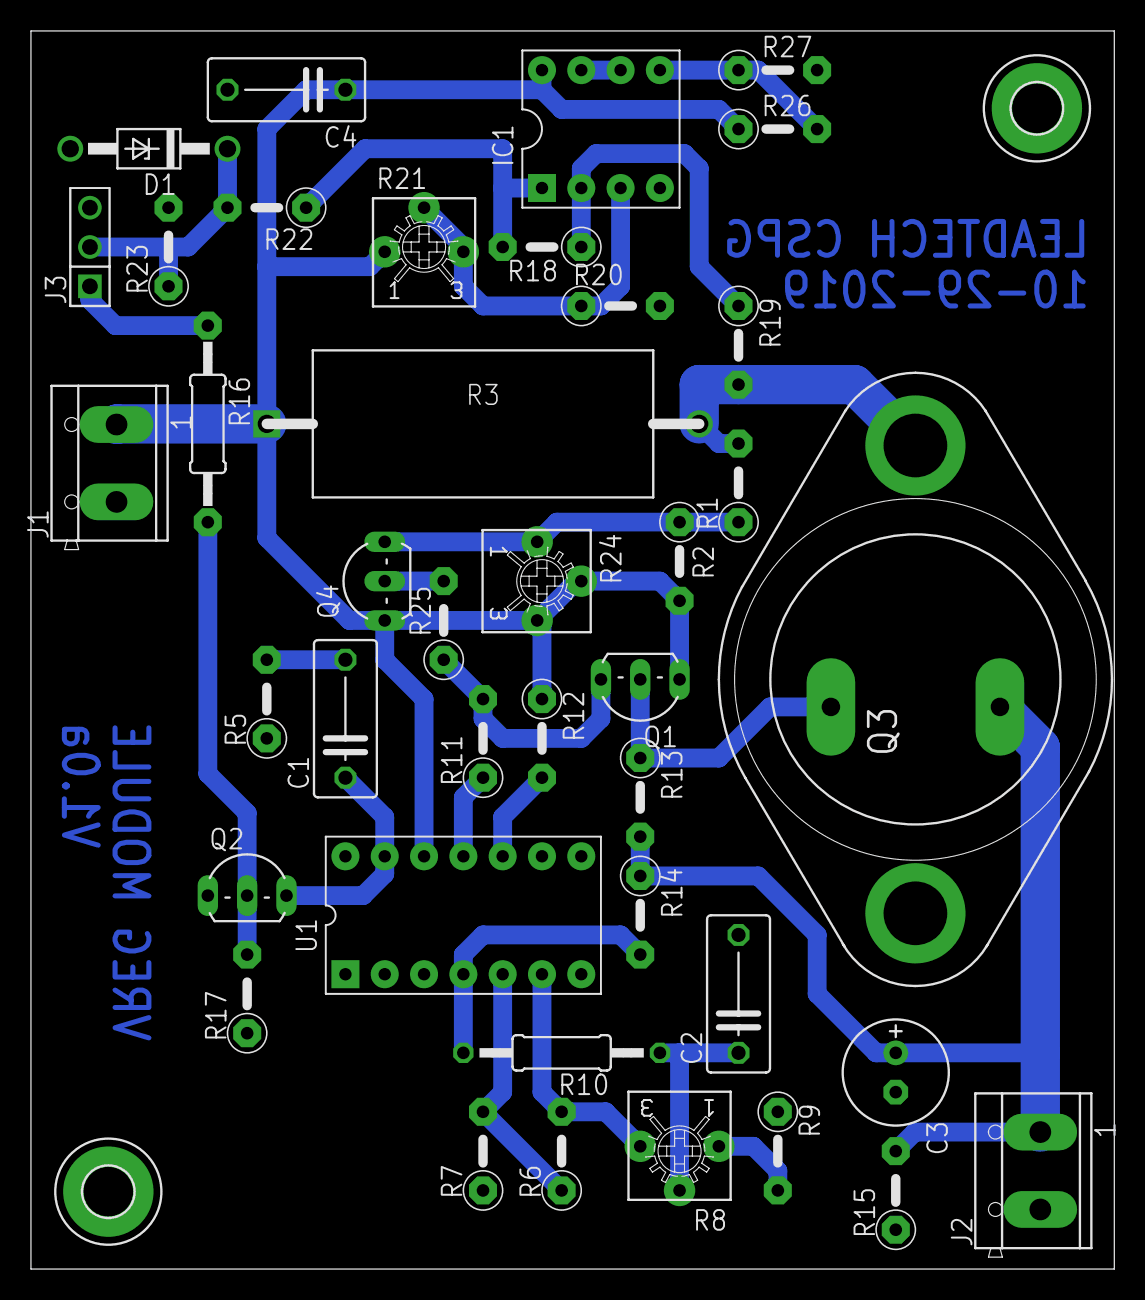
[picture p13: board LM723 voltage regulator.v1.0a.brd from above]

Board: 2 copper layers, 70.0 x 80.0 mm, 43 parts (0 on the bottom side), 25 nets.
