vimark/Leadtech-arduino-CSPG/hardware/leadtech-arduino-CSPG_concept.brd

## EAGLE design hardware/leadtech-arduino-CSPG_concept.brd (2020-03-18)

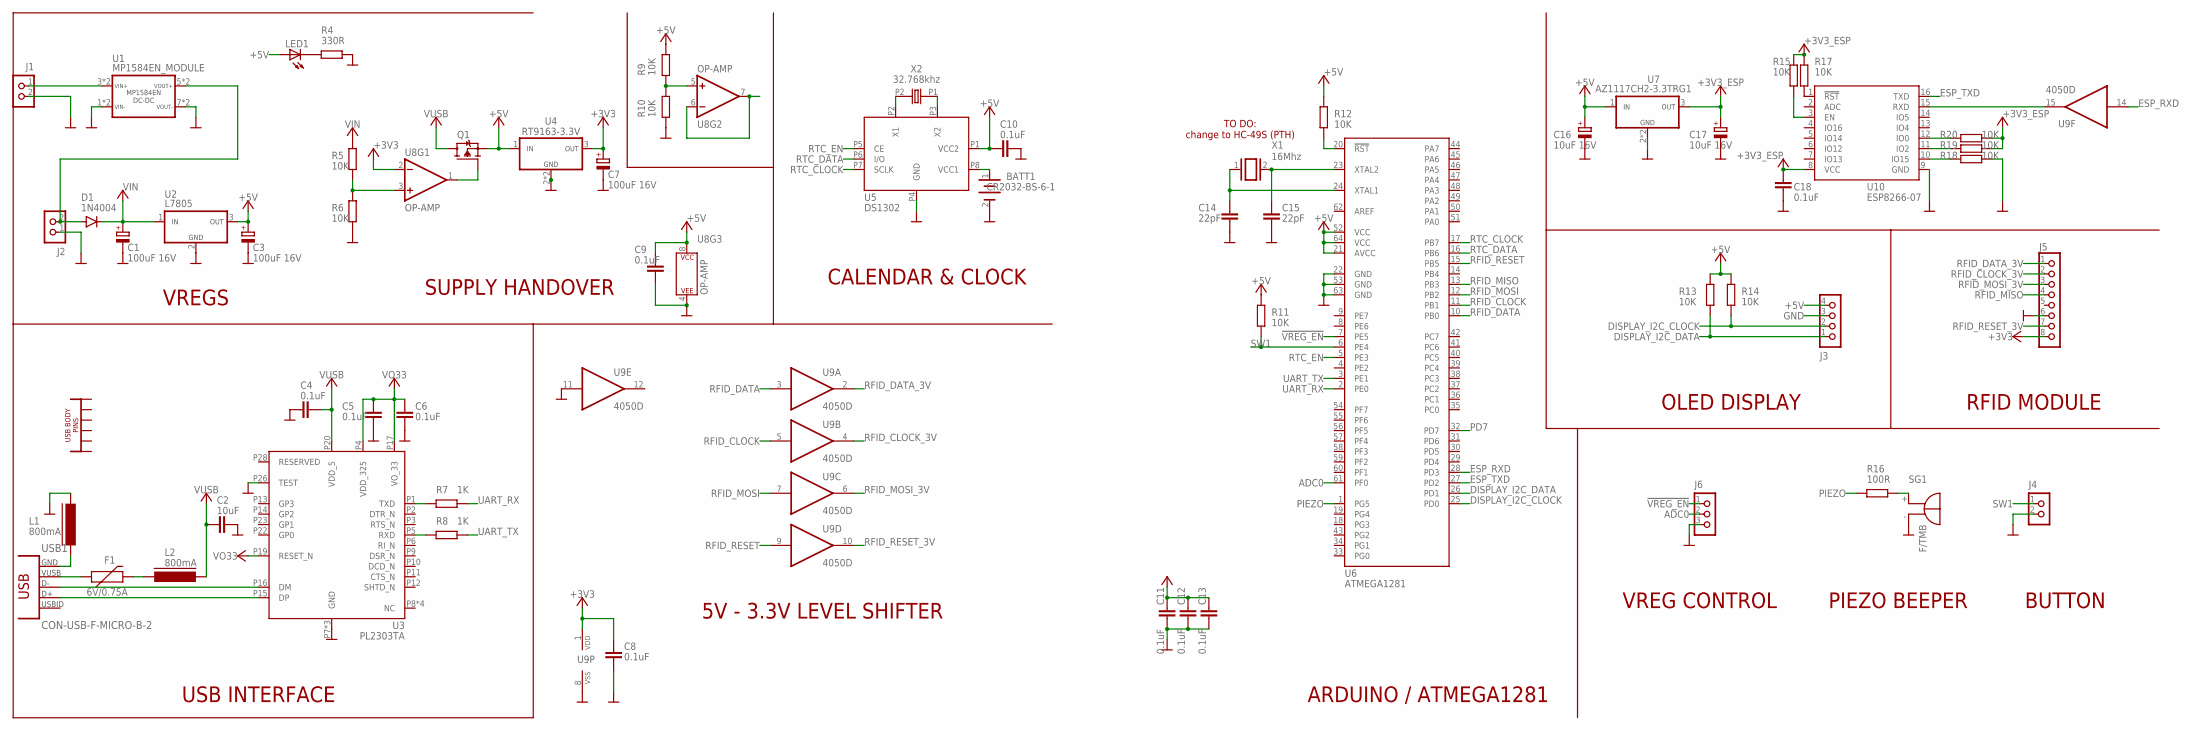
[picture p14: schematic leadtech-arduino-CSPG_concept.sch]

Parts:
BATT1: CR2032-BS-6-1; CR2032-BS-6
C1, C3, C7: 100uF 16V; CASE_C
C2: 10uF; C0603
C4, C5, C6, C8, C9, C10, C11, C12, C13, C18: 0.1uF; C0603
C14, C15: 22pF; C0603
C16, C17: 10uF 16V; CASE_B
D1: 1N4004; DO41-10
F1: 6V/0.75A; 1206
J1: CON_HX42003_2; HX42003-2WAF
J2: CON_HEADER_1X02-PTH; M1X2
J3: 2510-4AGW; KF2510-4AGW-2
J4: CON_KF2510-2AGW; KF2510-2AGW
J5: CON_HEADER_1X08-PTH; M1X8
J6: CON_KF2510-3A; KF2510-3A
L1, L2: 800mA; FB805
LED1: LED-0805; LED-805
Q1: TRANSISTOR_FET_TSM2301CX; SOT-23
R4: 330R; R603
R5, R6, R9, R10, R15, R17, R18, R19, R20: 10K; R603
R7, R8: 1K; R603
R11, R12, R13, R14: 10K; R0603
R16: 100R; R0603
SG1: F/TMB
U1: MP1584EN_MODULE; MP1584EN_DCDC_MODULE
U2: L7805; DPAK
U3: PL2303TA; SSOP-28
U4: RT9163-3.3V; SOT-223
U5: DS1302; SOIC-8
U6: ATMEGA1281; TQFP-64
U7: AZ1117CH2-3.3TRG1; SOT-223
U8: OP-AMP; SO08
U9: 4050D; SO16
U10: ESP8266-07
USB1: CON-USB-F-MICRO-B-2; CON_USB_MICRO-B-2-SD-47589-001
X1: 16Mhz; QS
X2: 32.768khz; TC-26

Connections:
!VREG_EN: J6.1, U6.7 (PE5)
+3V3: C7.+, C8.2, J5.8, U4.3 (VOUT), U8.2 (-IN), U9.1 (VDD)
+3V3_ESP: C17.+, C18.2, R15.2, R17.2, R18.1, R19.1, U7.3 (VOUT), U10.8 (VCC)
+5V: C3.+, C9.2, C10.1, C11.1, C12.1, C13.1, C16.+, J3.4, LED1.A, Q1.2 (S), R9.2, R11.2, R12.2, R13.2, R14.2, U2.3 (VOUT), U4.1 (VIN), U5.P1 (VCC2), U6.21 (AVCC), U6.52 (VCC), U6.64 (VCC), U7.1 (VIN), U8.8 (P$V+)
ADC0: J6.2, U6.61 (PF0)
DISPLAY_I2C_CLOCK: J3.2, R14.1, U6.25 (PD0)
DISPLAY_I2C_DATA: J3.1, R13.1, U6.26 (PD1)
ESP_RXD: U6.28 (PD3), U9.14 (I)
ESP_TXD: U6.27 (PD2), U10.16 (TXD)
GND: BATT1.2 (B-), C1.-, C2.1, C3.-, C4.1, C5.2, C6.2, C7.-, C8.1, C9.1, C10.2, C11.2, C12.2, C13.2, C14.1, C15.1, C16.-, C17.-, C18.1, J1.2, J2.1, J3.3, J4.2, J5.6, J6.3, L1.1, R4.2, R6.1, R10.1, R20.1, SG1.-, U1.1 (VIN-), U1.2 (VIN-), U1.7 (VOUT-), U1.8 (VOUT-), U2.2 (GND), U3.P7 (GND), U3.P18 (GND), U3.P25 (GND), U3.P26 (TEST), U4.2 (GND), U4.4 (GND), U5.P4 (GND), U6.22 (GND), U6.53 (GND), U6.63 (GND), U7.2 (GND), U7.4 (GND), U8.4 (P$V-), U9.8 (VSS), U9.11 (I), U10.9 (GND)
unnamed: R17.1, U10.1 (!RST)
unnamed: R15.1, U10.3 (EN)
unnamed: R12.1, U6.20 (!RST)
unnamed: Q1.1 (G), U8.1 (OUT)
unnamed: R5.1, R6.2, U8.3 (+IN)
unnamed: U8.6 (-IN), U8.7 (OUT)
unnamed: J1.1, U1.3 (VIN+), U1.4 (VIN+)
unnamed: C15.2, U6.23 (XTAL2), X1.2
unnamed: R9.1, R10.2, U8.5 (+IN)
unnamed: C14.2, U6.24 (XTAL1), X1.1
unnamed: U3.P16 (DM), USB1.P2 (D-)
unnamed: U3.P15 (DP), USB1.P3 (D+)
unnamed: F1.1, USB1.P1 (VUSB)
unnamed: F1.2, L2.2
unnamed: L1.2, USB1.P5 (GND)
unnamed: R7.1, U3.P1 (TXD)
unnamed: R8.1, U3.P5 (RXD)
unnamed: D1.A, J2.2, U1.5 (VOUT+), U1.6 (VOUT+)
unnamed: R16.2, SG1.+
unnamed: LED1.C, R4.1
unnamed: U5.P3 (X2), X2.P1 (1)
unnamed: U5.P2 (X1), X2.P2 (2)
unnamed: BATT1.1 (B+), U5.P8 (VCC1)
unnamed: R20.2, U10.10 (IO15)
unnamed: R19.2, U10.11 (IO2)
unnamed: R18.2, U10.12 (IO0)
unnamed: U9.15 (O), U10.15 (RXD)
PD7: U6.32 (PD7)
PIEZO: R16.1, U6.1 (PG5)
RFID_CLOCK: U6.11 (PB1), U9.5 (I)
RFID_CLOCK_3V: J5.2, U9.4 (O)
RFID_DATA: U6.10 (PB0), U9.3 (I)
RFID_DATA_3V: J5.1, U9.2 (O)
RFID_MISO: J5.4, U6.13 (PB3)
RFID_MOSI: U6.12 (PB2), U9.7 (I)
RFID_MOSI_3V: J5.3, U9.6 (O)
RFID_RESET: U6.15 (PB5), U9.9 (I)
RFID_RESET_3V: J5.7, U9.10 (O)
RTC_CLOCK: U5.P7 (SCLK), U6.17 (PB7)
RTC_DATA: U5.P6 (I/O), U6.16 (PB6)
RTC_EN: U5.P5 (CE), U6.5 (PE3)
SW1: J4.1, R11.1, U6.6 (PE4)
UART_RX: R7.2, U6.2 (PE0)
UART_TX: R8.2, U6.3 (PE1)
VIN: C1.+, D1.C, R5.2, U2.1 (VIN)
VO33: C5.1, C6.1, U3.P4 (VDD_325), U3.P17 (VO_33), U3.P19 (RESET_N)
VUSB: C2.2, C4.2, L2.1, Q1.3 (D), U3.P20 (VDD_5)

Notes on the sheet:
USB INTERFACE
VREGS
CALENDAR & CLOCK
ARDUINO / ATMEGA1281
RFID MODULE
5V - 3.3V LEVEL SHIFTER
TO DO: change to HC-49S (PTH)
OLED DISPLAY
PIEZO BEEPER
SUPPLY HANDOVER
BUTTON
VREG CONTROL

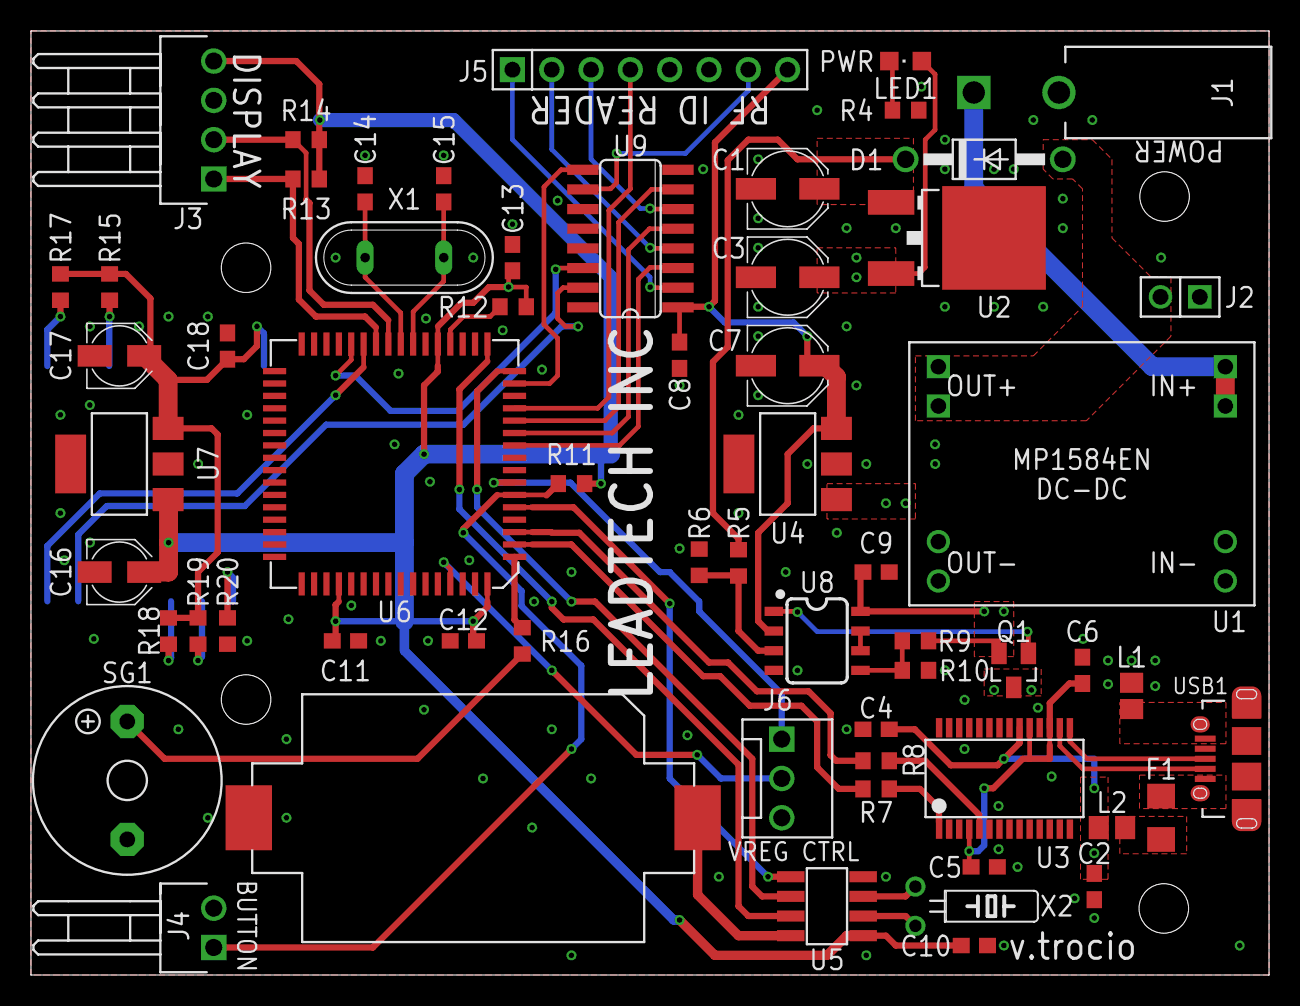
[picture p15: board leadtech-arduino-CSPG_concept.brd from above]

Board: 2 copper layers, 80.0 x 61.0 mm, 62 parts (1 on the bottom side), 56 nets.
