vimark/Leadtech-arduino-CSPG/sketches/DS1302_Serial/DS1302_Serial.ino

// DS1302_Serial_Easy (C)2010 Henning Karlsen
// web: http://www.henningkarlsen.com/electronics
//
// Adopted for DS1302RTC library by Timur Maksimov 2014
//
// A quick demo of how to use my DS1302-library to 
// quickly send time and date information over a serial link
//
// I assume you know how to connect the DS1302.
// DS1302:  CE pin    -> Arduino Digital 27, 5
//          I/O pin   -> Arduino Digital 29, 6
//          SCLK pin  -> Arduino Digital 31, 7
//          VCC pin   -> Arduino Digital 33, 5V
//          GND pin   -> Arduino Digital 35, GND

#include <Time.h>
#include <DS1302RTC.h>
#include <TimeLib.h>

// Set pins:  CE, IO,CLK
DS1302RTC RTC(5, 6, 7);

// Optional connection for RTC module
#define DS1302_GND_PIN 33
#define DS1302_VCC_PIN 35

void setup()
{

  // Setup Serial connection
  Serial.begin(9600);
  
  Serial.println("DS1302RTC Read Test");
  Serial.println("-------------------");
  
  // Activate RTC module
  digitalWrite(DS1302_GND_PIN, LOW);
  pinMode(DS1302_GND_PIN, OUTPUT);

  digitalWrite(DS1302_VCC_PIN, HIGH);
  pinMode(DS1302_VCC_PIN, OUTPUT);
  
  Serial.println("RTC module activated");
  Serial.println();
  delay(500);
  
  if (RTC.haltRTC()) {
    Serial.println("The DS1302 is stopped.  Please run the SetTime");
    Serial.println("example to initialize the time and begin running.");
    Serial.println();
  }
  if (!RTC.writeEN()) {
    Serial.println("The DS1302 is write protected. This normal.");
    Serial.println();
  }
  
  delay(5000);
}

void loop()
{
  tmElements_t tm;
  
  Serial.print("UNIX Time: ");
  Serial.print(RTC.get());

  if (! RTC.read(tm)) {
    Serial.print("  Time = ");
    print2digits(tm.Hour);
    Serial.write(':');
    print2digits(tm.Minute);
    Serial.write(':');
    print2digits(tm.Second);
    Serial.print(", Date (D/M/Y) = ");
    Serial.print(tm.Day);
    Serial.write('/');
    Serial.print(tm.Month);
    Serial.write('/');
    Serial.print(tmYearToCalendar(tm.Year));
    Serial.print(", DoW = ");
    Serial.print(tm.Wday);
    Serial.println();
  } else {
    Serial.println("DS1302 read error!  Please check the circuitry.");
    Serial.println();
    delay(9000);
  }
  
  // Wait one second before repeating :)
  delay (1000);
}

void print2digits(int number) {
  if (number >= 0 && number < 10)
    Serial.write('0');
  Serial.print(number);
}
