vimark/Leadtech-arduino-CSPG/(commit log)

2019-08-09 add atmega1281 mcu
    [leadtech-arduino-CSPG_concept.sch]
2019-08-23 started routing schematic
    [leadtech-arduino-CSPG_concept.sch]
2019-08-25 building schematic
    [leadtech-arduino-CSPG_concept.sch]
2019-08-26 continue wiring schematic
    [leadtech-arduino-CSPG_concept.brd, leadtech-arduino-CSPG_concept.sch]
2019-08-28 add project schedule excel, add RFID module on schematic
    [leadtech-arduino-CSPG_concept.brd, leadtech-arduino-CSPG_concept.sch, time table.xls]
2019-08-30 continue wiring schematic, RFIF wiring done, level shifter done, add BOM with links on excel sheet
    [leadtech-arduino-CSPG_concept.brd, leadtech-arduino-CSPG_concept.sch, time table.xls]
2019-08-30 continue on schematic work, add i2c OLED
    [leadtech-arduino-CSPG_concept.brd, leadtech-arduino-CSPG_concept.sch, time table.xls]
2019-09-01 add box plate, i2c oled sketch
    [box_plate.dwg]
2019-09-04 edited box plate drawing, added chip docs
    [box_plate.dwg, leadtech-arduino-CSPG_concept.sch, time table.xls]
2019-09-06 worked with enclosure design for demo set-up
    [box_plate.dwg]
2019-09-11 added buzzer function, add circuit for regulated output
    [time table.xls]
2019-09-13 made some rev on dwg and schematic
    [box_plate.dwg, leadtech-arduino-CSPG_concept.sch]
2019-09-14 update dwg
    [box_plate.dwg]
2019-09-18 update files
    [leadtech-arduino-CSPG_concept.brd, leadtech-arduino-CSPG_concept.sch, time table.xls]
2019-09-21 fix sizes of modules
    [box_plate.dwg]
2019-10-02 add spice simulations, documents
    [box_plate.dwg, time table.xls]
2019-10-03 fix mounting holes for solar home kit
    [box_plate.dwg]
2019-10-06 small updates
    [leadtech-arduino-CSPG_concept.sch, time table.xls]
2019-10-07 updated vendor box drawings
    [vendor_box.dwg]
2019-10-07 fix cspg vendor sketch
    [cspg_vendor_main.ino]
2019-10-07 updates on vendo box
    [vendor_box.dwg]
2019-10-08 fix vendor box
    [vendor_box.dwg]
2019-10-08 add corel v14 of vendor box laser cutout
    [vendor_box.dwg]
2019-10-10 move to do notes to other git repo, fix vendo box design
    [box_plate.dwg, time table.xls]
2019-10-12 add gizduino pins on schematic, add bug comment on value of month on vendor firmware, add time sketches
    [leadtech-arduino-CSPG_concept.sch]
2019-10-15 fix bug when month is set to greater than 9, add PDF printout of schematic
    [cspg_customer_main.ino]
2019-10-17 fix year display on standby, double the size of load text on printed reciept
    [cspg_customer_main.ino, cspg_vendor_main.ino]
2019-10-18 added costing and consting printouts
    [Costing.xlsx]
2019-10-27 made board for LM723, update prepaid metering module placement
    [LM723 voltage regulator.brd, LM723 voltage regulator.sch, Purchase List - prepaid metering.xlsx, box_plate.dwg, vendor_box.dwg]
2019-10-30 fix circuit and made 2 panelized board
    [LM723 voltage regulator.brd, LM723 voltage regulator.sch]
2020-01-01 added new LM723 reference schematic from a known PSU
2020-01-09 varous files updates
    [box_plate.dwg]
2020-01-11 added test result excel
    [Test result.xlsx]
2020-01-31 renamed some docs
    [Prepaid Metering System - costing.xlsx]
2020-02-04 fix grace period when overloaded
    [cspg_customer_main_current_sense.ino, hardware.h]
2020-02-08 revised prepaid metering front panel text
    [box_plate.dwg]
2020-02-09 added new identification functionality of RFID for each meter, fix time sync via monitor command
    [cspg_customer_main_current_sense.ino, cspg_vendor_main.ino, hardware.h]
2020-02-10 implement card association to its meter, simple command line implementation via serial, configuration saving to RTC ram
    [vendor_box.dwg]
2020-02-10 implement serial commands, fix RTC RAM settings partitioning on time out and time rate
    [cspg_customer_main_current_sense.ino]
2020-02-12 fix active status bug
    [cspg_customer_main_current_sense.ino]
2020-02-13 fix buzzer endifs, RTC now works
    [cspg_customer_main_current_sense.ino, hardware.h]
2020-02-17 added load deletion on vendor firmware, fix current not sensing when card was swiped on client firmware, added censor directives on client firmware
    [cspg_customer_main_current_sense.ino, cspg_vendor_main.ino, hardware.h]
2020-02-18 add kicad under pcb
    [under_pcb.kicad_pcb, under_pcb.sch]
2020-02-19 wiring and routing under pcb
    [under_pcb.kicad_pcb, under_pcb.sch, under_pcb_placement.FCStd]
2020-02-19 board routing donr on under_pcb/patty board
    [under_pcb.kicad_pcb, under_pcb.sch]
2020-02-20 update results, updated patty board
    [Test result.xlsx, under_pcb.kicad_pcb]
2020-02-21 edit CSPG arduino hardware
    [leadtech-arduino-CSPG_concept.brd, leadtech-arduino-CSPG_concept.sch]
2020-02-22 test result updated for electronic load reading, changed meter user to master user for testing only
    [Test result.xlsx]
2020-02-25 worked on schematic
    [leadtech-arduino-CSPG_concept.brd, leadtech-arduino-CSPG_concept.sch]
2020-02-26 separated released firmware folder
    [Test result.xlsx]
2020-02-28 fix serial commands RATE, TIMOUT, working on ID command, add notes on tl494 schematic
    [cspg_customer_main_current_sense.ino, hardware.h]
2020-03-01 add supply jumper on OLED for patty board
    [under_pcb.kicad_pcb, under_pcb.sch]
2020-03-01 add power source manager op-amp wiring
    [leadtech-arduino-CSPG_concept.brd, leadtech-arduino-CSPG_concept.sch]
2020-03-09 continue routing board
    [leadtech-arduino-CSPG_concept.brd, leadtech-arduino-CSPG_concept.sch]
2020-03-17 done routing, add bom
    [leadtech-arduino-CSPG_concept-bom.xlsx, leadtech-arduino-CSPG_concept.brd, leadtech-arduino-CSPG_concept.sch]
2020-03-17 making bom
    [leadtech-arduino-CSPG_concept-bom.xlsx, leadtech-arduino-CSPG_concept.brd, leadtech-arduino-CSPG_concept.sch]
2020-03-18 finish routing main board and bom
    [LM723 voltage regulator-bom.xlsx, LM723 voltage regulator.sch, leadtech-arduino-CSPG_concept-bom.xlsx, leadtech-arduino-CSPG_concept.brd, leadtech-arduino-CSPG_concept.sch]
2020-03-18 revision on main board
    [LM723 voltage regulator-bom.xlsx, LM723 voltage regulator.v1.0a.brd, LM723 voltage regulator.v1.0a.sch, LM723 voltage regulator.v1.0b.brd, LM723 voltage regulator.v1.0b.sch, leadtech-arduino-CSPG_concept-bom.xlsx, leadtech-arduino-CSPG_concept.brd, leadtech-arduino-CSPG_concept.sch]
