vimark/Leadtech-arduino-CSPG/(notices)

Notices in the files:
parts and their libraries:
SparkFun-IC-Amplifiers: Licensing: Creative Commons ShareAlike 4.0 International - https://creativecommons.org/licenses/by-sa/4.0
dp_devices.v6: LICENSE: CC-BY-SA
